openedv/development_board_ATK-DLRK3588B/1_codes/README.md

## Codes

You can find the codes by clicking on [here](https://mega.nz/folder/T1QyjKSI#ysQfY6-w_V1g0kBio79TOQ).
