openedv/development_board_ATK-DLRK3588B/7_hardware/5_Board_mounted_connector_specifications/03_USB-A_connector/Type-A base - copper - side plug.docx

Attribute | Parameter value
Product Catalogue | USB connector
Connector Types | Type-A
Standard | USB 2.0
Male and female | Female
Number of contacts | 4
Number of ports | 1

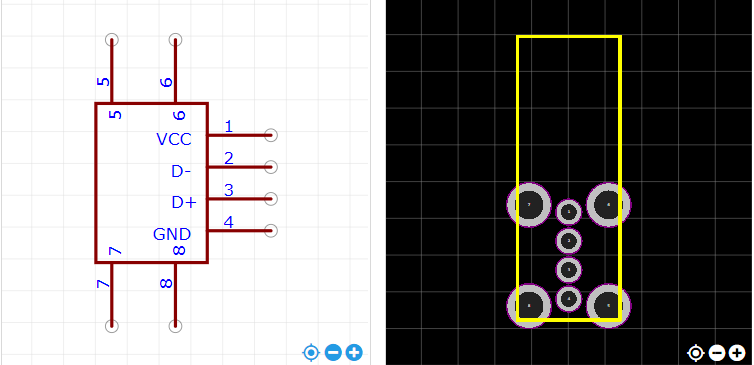
[picture p1: figure]

https://item.szlcsc.com/26978.html
