openedv/development_board_ATK-DLRK3588B/7_hardware/5_Board_mounted_connector_specifications/06_DC_power_socket/DC Port 5.5_2.1.docx

Product Catalogue | AC/DC power connector
Connector Types | DC power socket
Installation method | Curved plug
Contact inner diameter | -
Contact outer diameter | -
Rated current | 5A
Rated voltage | 20V
Operating temperature range | -25℃~+70℃

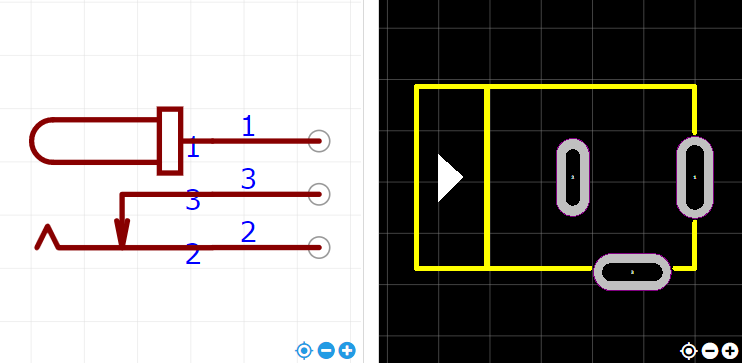
[picture p2: figure]

https://item.szlcsc.com/419795.html
