openedv/development_board_ATK-DLRK3588B/7_hardware/5_Board_mounted_connector_specifications/07_TF_card_slot/Self-playing MicroSD card (TF card) slot.docx

Product Catalogue | SD card connector
Card connection method | Self-folding type
Card type | MicroSD card (TF card)
Connector type | Card slot
Maximum height of the body | -
Contact material | -
Contact coating | -
Operating temperature range | -
Welding temperature (maximum value) | -

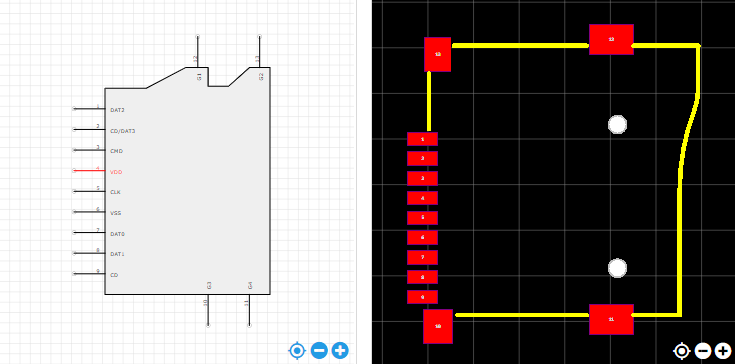
[picture p3: figure]

https://item.szlcsc.com/112422.html
