openedv/development_board_ATK-DLRK3588B/7_hardware/5_Board_mounted_connector_specifications/08_NANO_SIM_card_slot/Self-playing NanoSIM card slot 7P without pillars.docx

Product Catalogue | SIM card connector
Card connection method | Self-retracting type
Card type | NanoSIM card
Connector type | Card slot
Maximum height of the body | 1.25mm
Contact material | Copper alloy
Contact coating | Gold plating
Operating temperature range | -40℃~+85℃
Welding temperature (maximum value) | 260℃

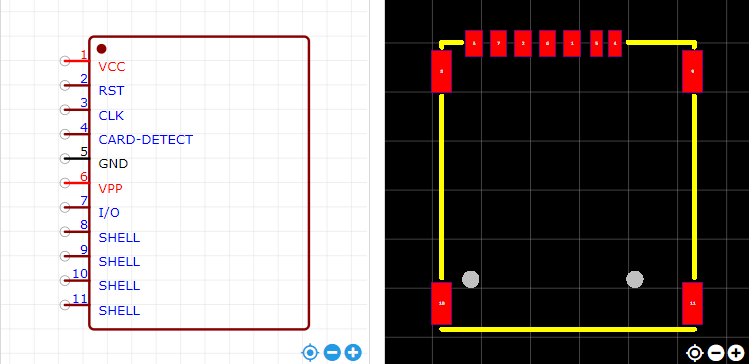
[picture p4: figure]

https://item.szlcsc.com/353303.html
