openedv/development_board_ATK-DLRK3588B/7_hardware/5_Board_mounted_connector_specifications/10_2mm_pitch_mounting_socket_22P(ALIENTEK_MIPI_Camera_Interface)/C2925567_2MM2X11P.docx

属性 | 参数值
商品目录 | 排母
间距 | 2mm
总孔位数 | 22
排数 | 2
插孔结构 | 2x11P
行距 | 2mm
安装类型 | 直插
圆孔/方孔 | 方孔
额定电流 | 2A
额定电压 | -
插孔方向 | 顶部
塑高 | 4.3mm
工作温度范围 | -40℃~+105℃

https://item.szlcsc.com/3245400.html
