openedv/development_board_ATK-DLRK3588B/7_hardware/5_Board_mounted_connector_specifications/11_FPC_Connector_26P (ALIENTEK_MIPI_Screen_Interface)/C2911851_0.5MMP quantity_26 flip-down connection.docx

Product Catalogue | FFC/FPC connector
Spacing | 0.5mm
Number of contacts | 26
Locking feature | Flip cover style
Installation type | Supporting pad for bed
Contact type | Continued below
Board height | 2mm
Thickness of the flexible cable connected | 0.3mm
Operating temperature range | -20℃~+85℃

https://item.szlcsc.com/3194107.html
