openedv/development_board_ATK-DLRK3588B/7_hardware/5_Board_mounted_connector_specifications/14_Antenna_base/RF radio frequency coaxial connector SMA inner hole elbow connector.docx

Product Catalogue | RF radio frequency coaxial connector
Connector type | Board end
Radio frequency series | SMA
Interface type | Inner bore
Number of ports | 1
Impedance | 50Ω
Frequency - Maximum value | 3GHz
Style | Bend
Interface diameter | 5.35mm
Interface length/height | -
Operating temperature range | -55℃~+125℃

External thread nut half-thread SMA - KWE bend angle (90 degrees), fully copper plated with gold

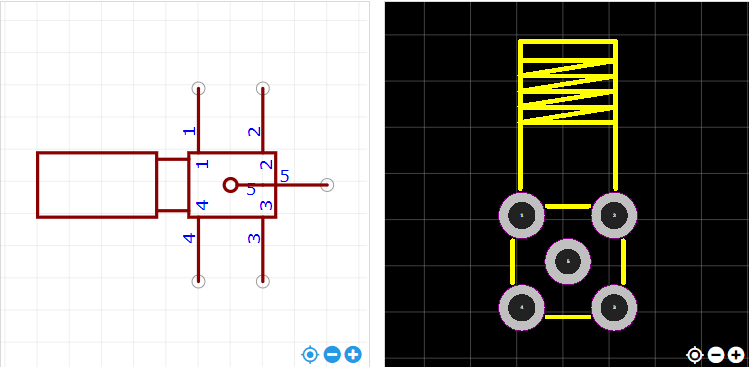
[picture p5: figure]

https://item.szlcsc.com/985455.html
