openedv/development_board_ATK-DLRK3588B/7_hardware/5_Board_mounted_connector_specifications/01_Core_board-to-board_connector/Copper column specifications M2x4x1.5 + 2.9x1.0mm.txt

购买链接参考：https://item.taobao.com/item.htm?spm=a1z09.2.0.0.31962e8d5RZ1vR&id=621670841713&_u=vjqt9po3ed8
