openedv/development_board_ATK-DLRK3588B/2_sch/02_Other_Modules_Schematic_Diagram/ATK-MCIMX415 V1.4 schematic diagram.pdf

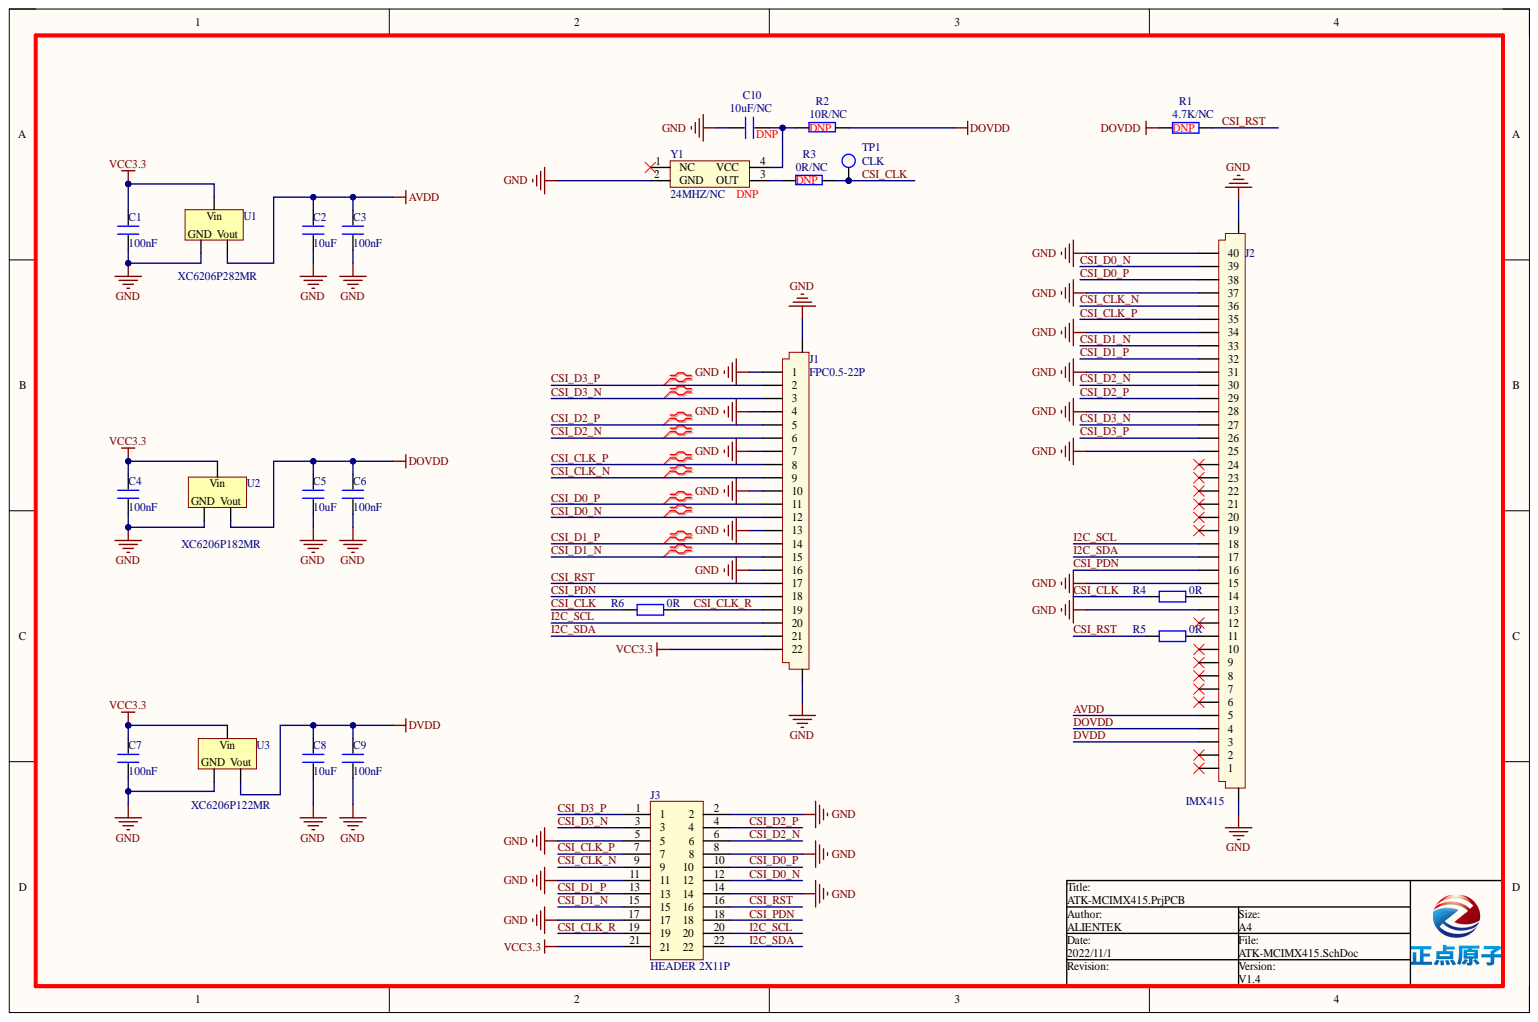
[picture p61: page 2]
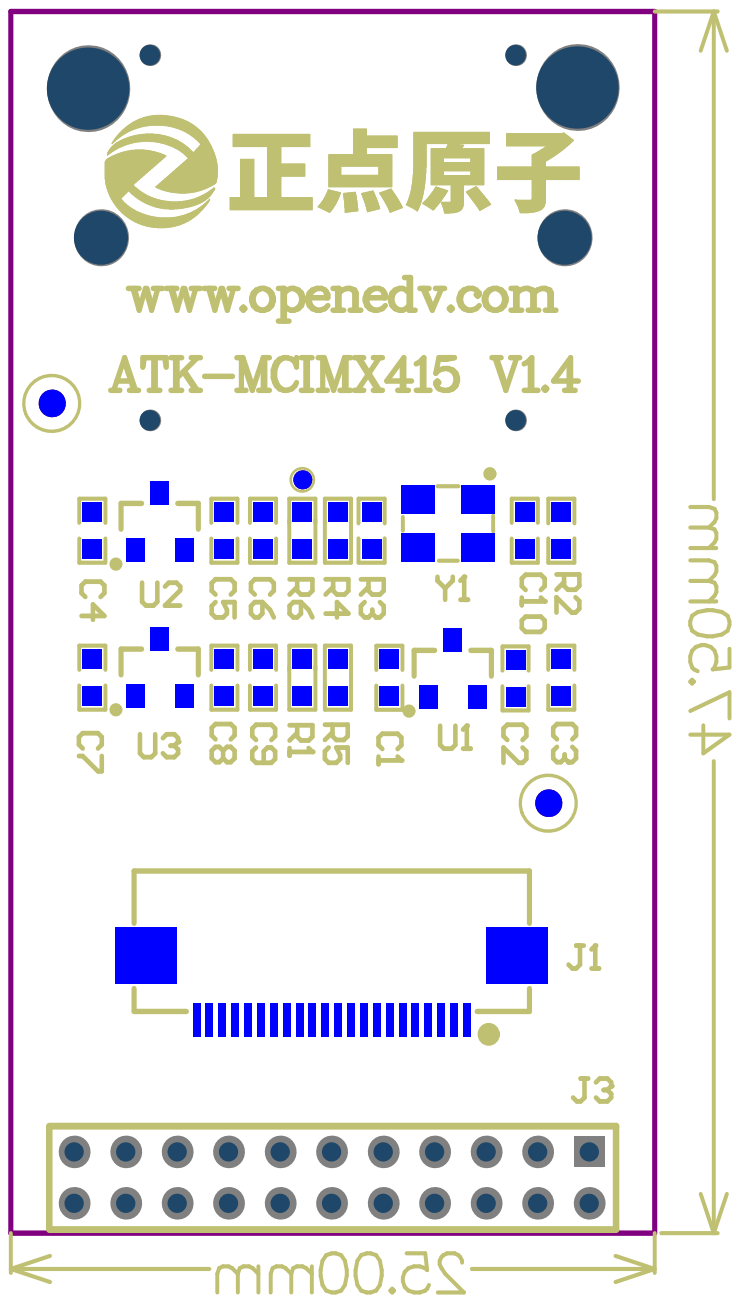
[picture p62: page 3]
