openedv/development_board_ATK-DLRK3588B/3_core_board_data/3_core_board_mechanical_structure/ATK-CLRK3588B V1.0(Core board structure size diagram).pdf

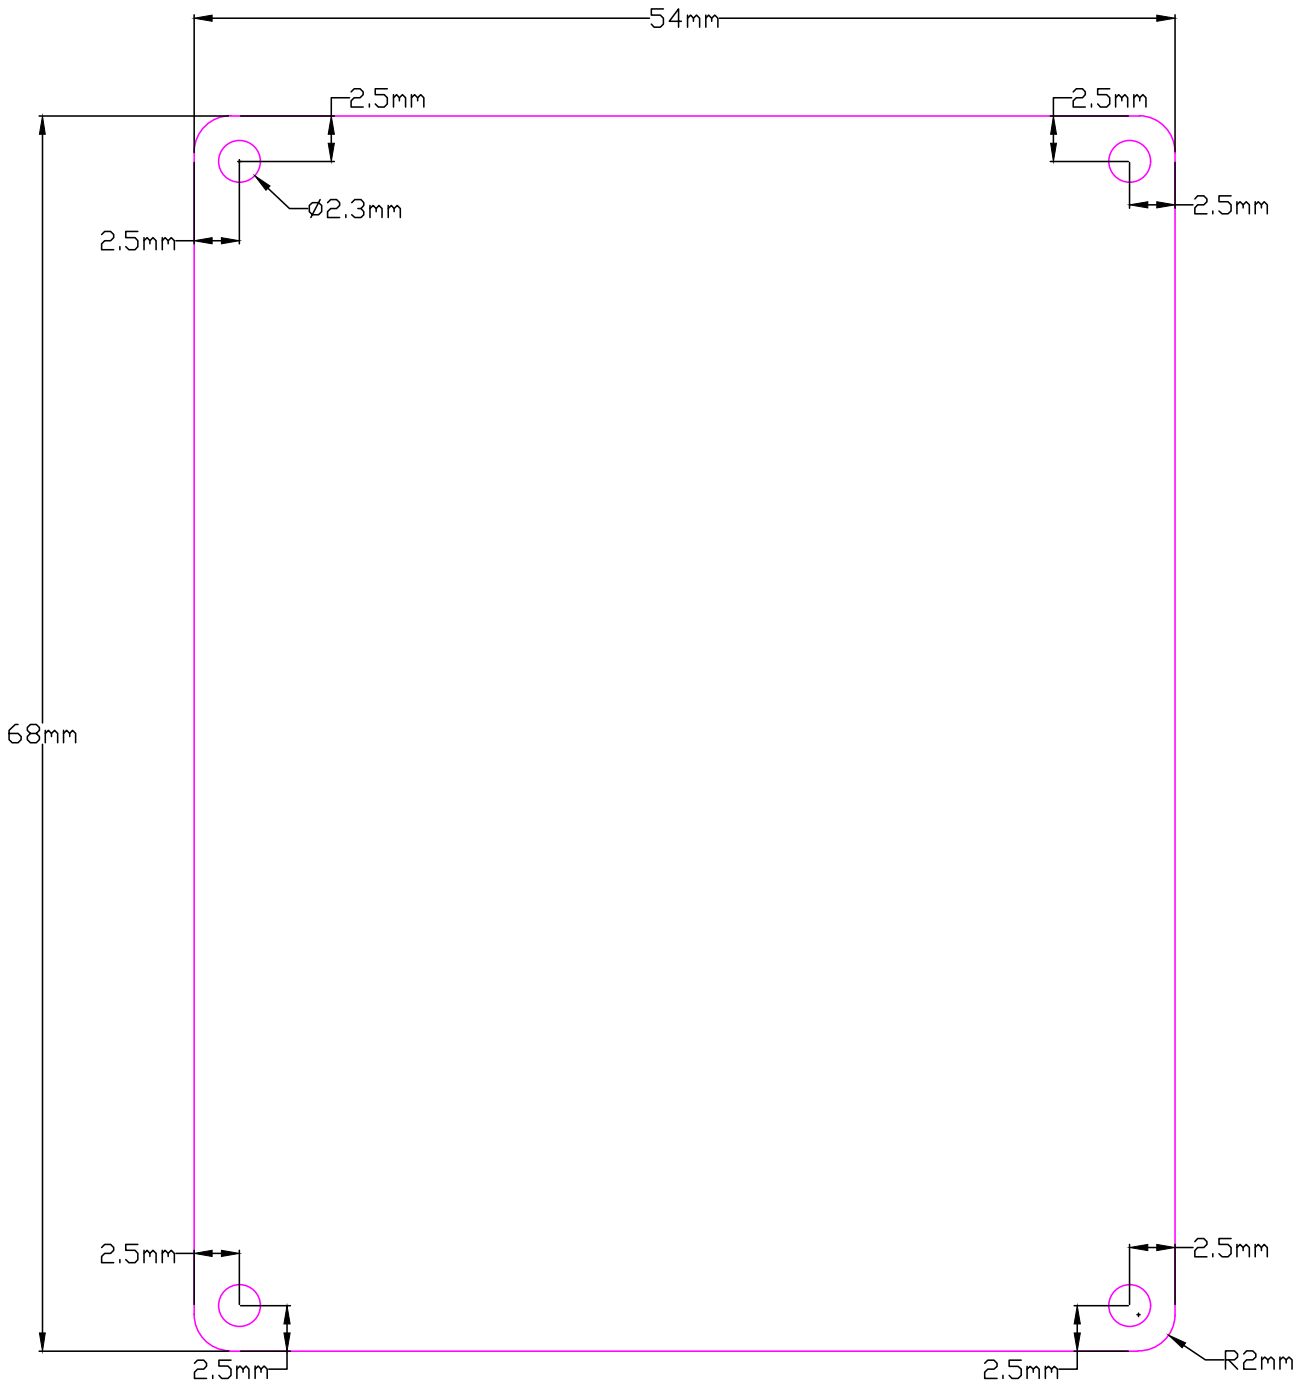
[picture p63: page 1]
