openedv/development_board_ATK-DLRK3588B/7_hardware/5_Board_mounted_connector_specifications/04_Type-C_Connector/USB 12P,Type C.pdf

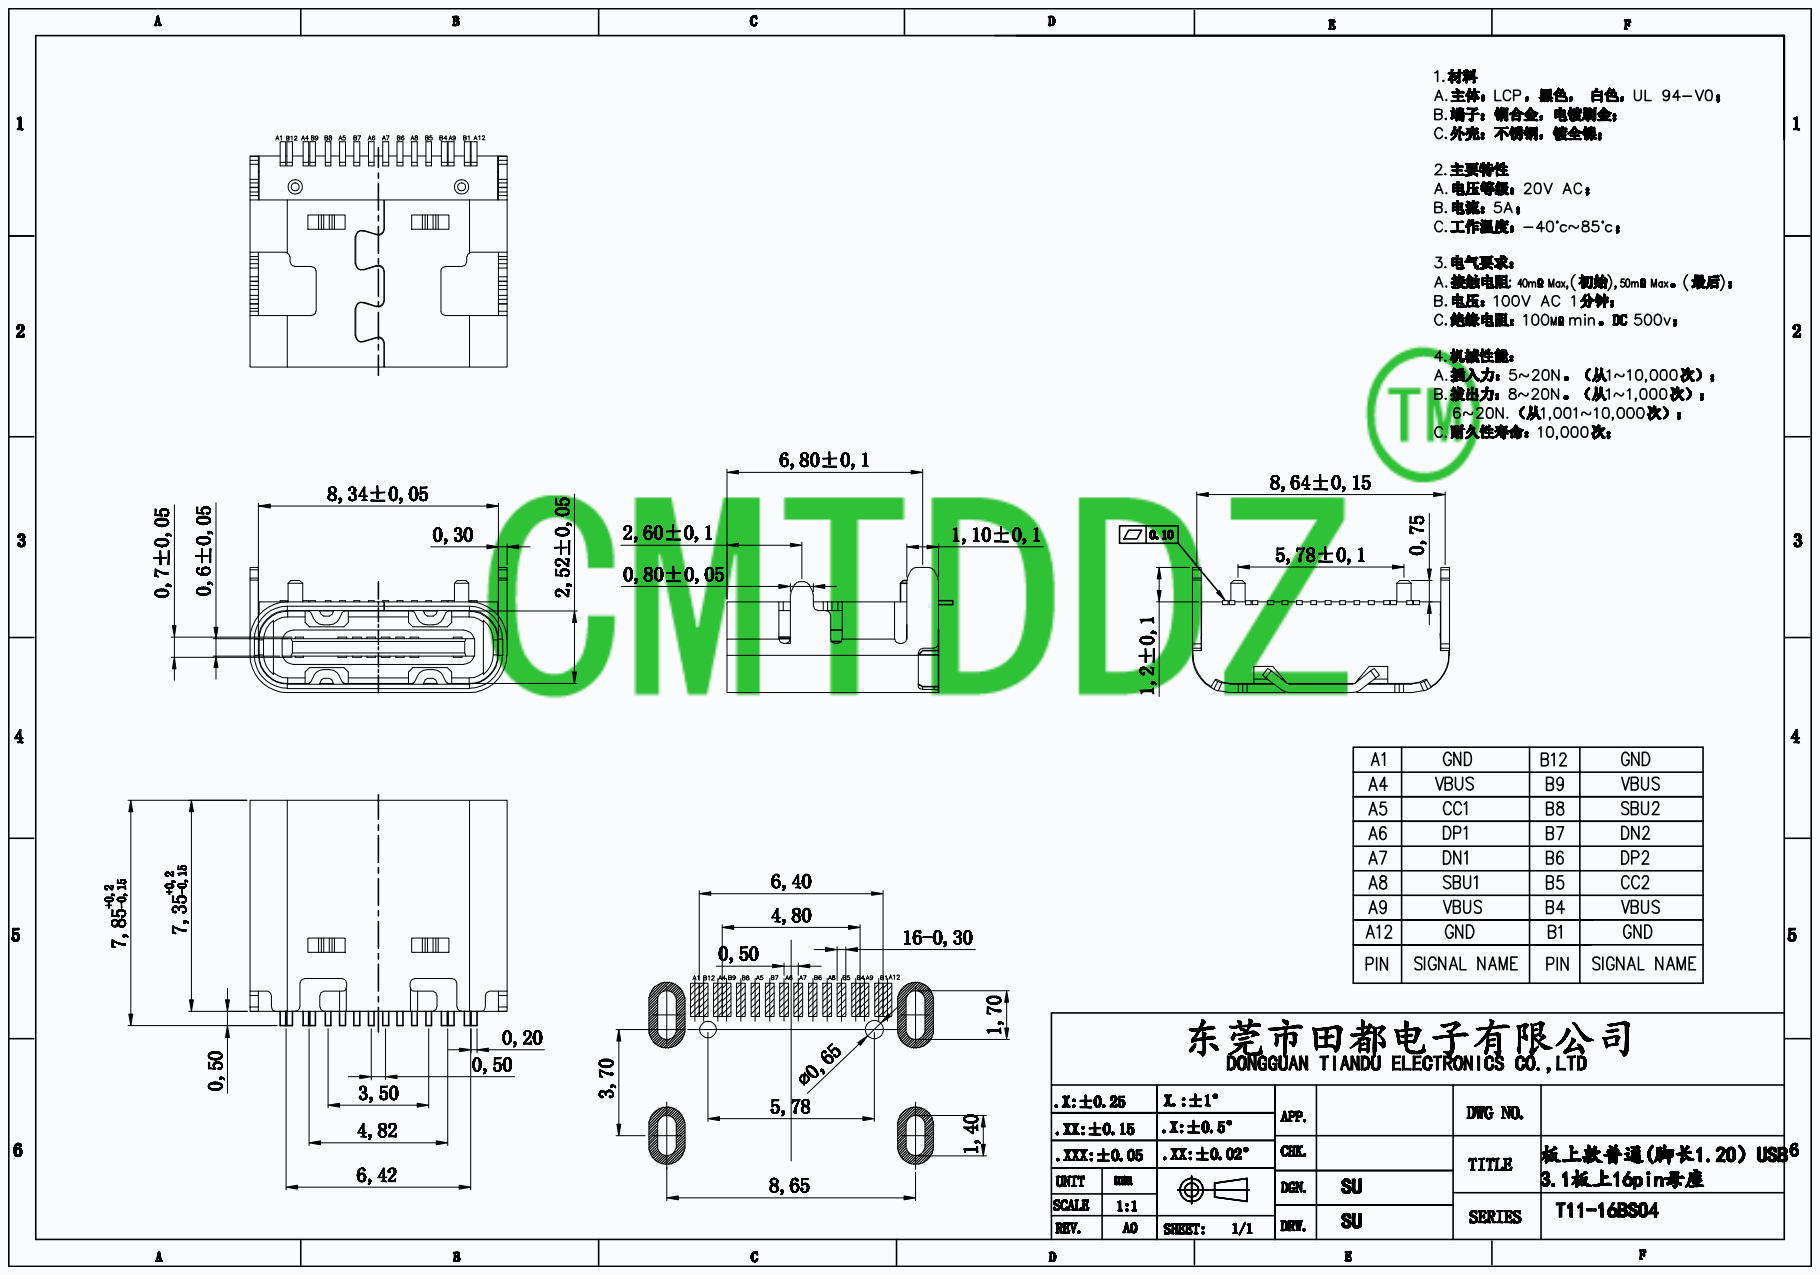
[picture p64: page 1]
