openedv/development_board_ATK-DLRK3588B/7_hardware/5_Board_mounted_connector_specifications/15_M.2_Socket/M.2 M_KEY Gold Finger Connector - LOTES (Jiaze Terminal) Gold Finger Connector Specification Book.PDF

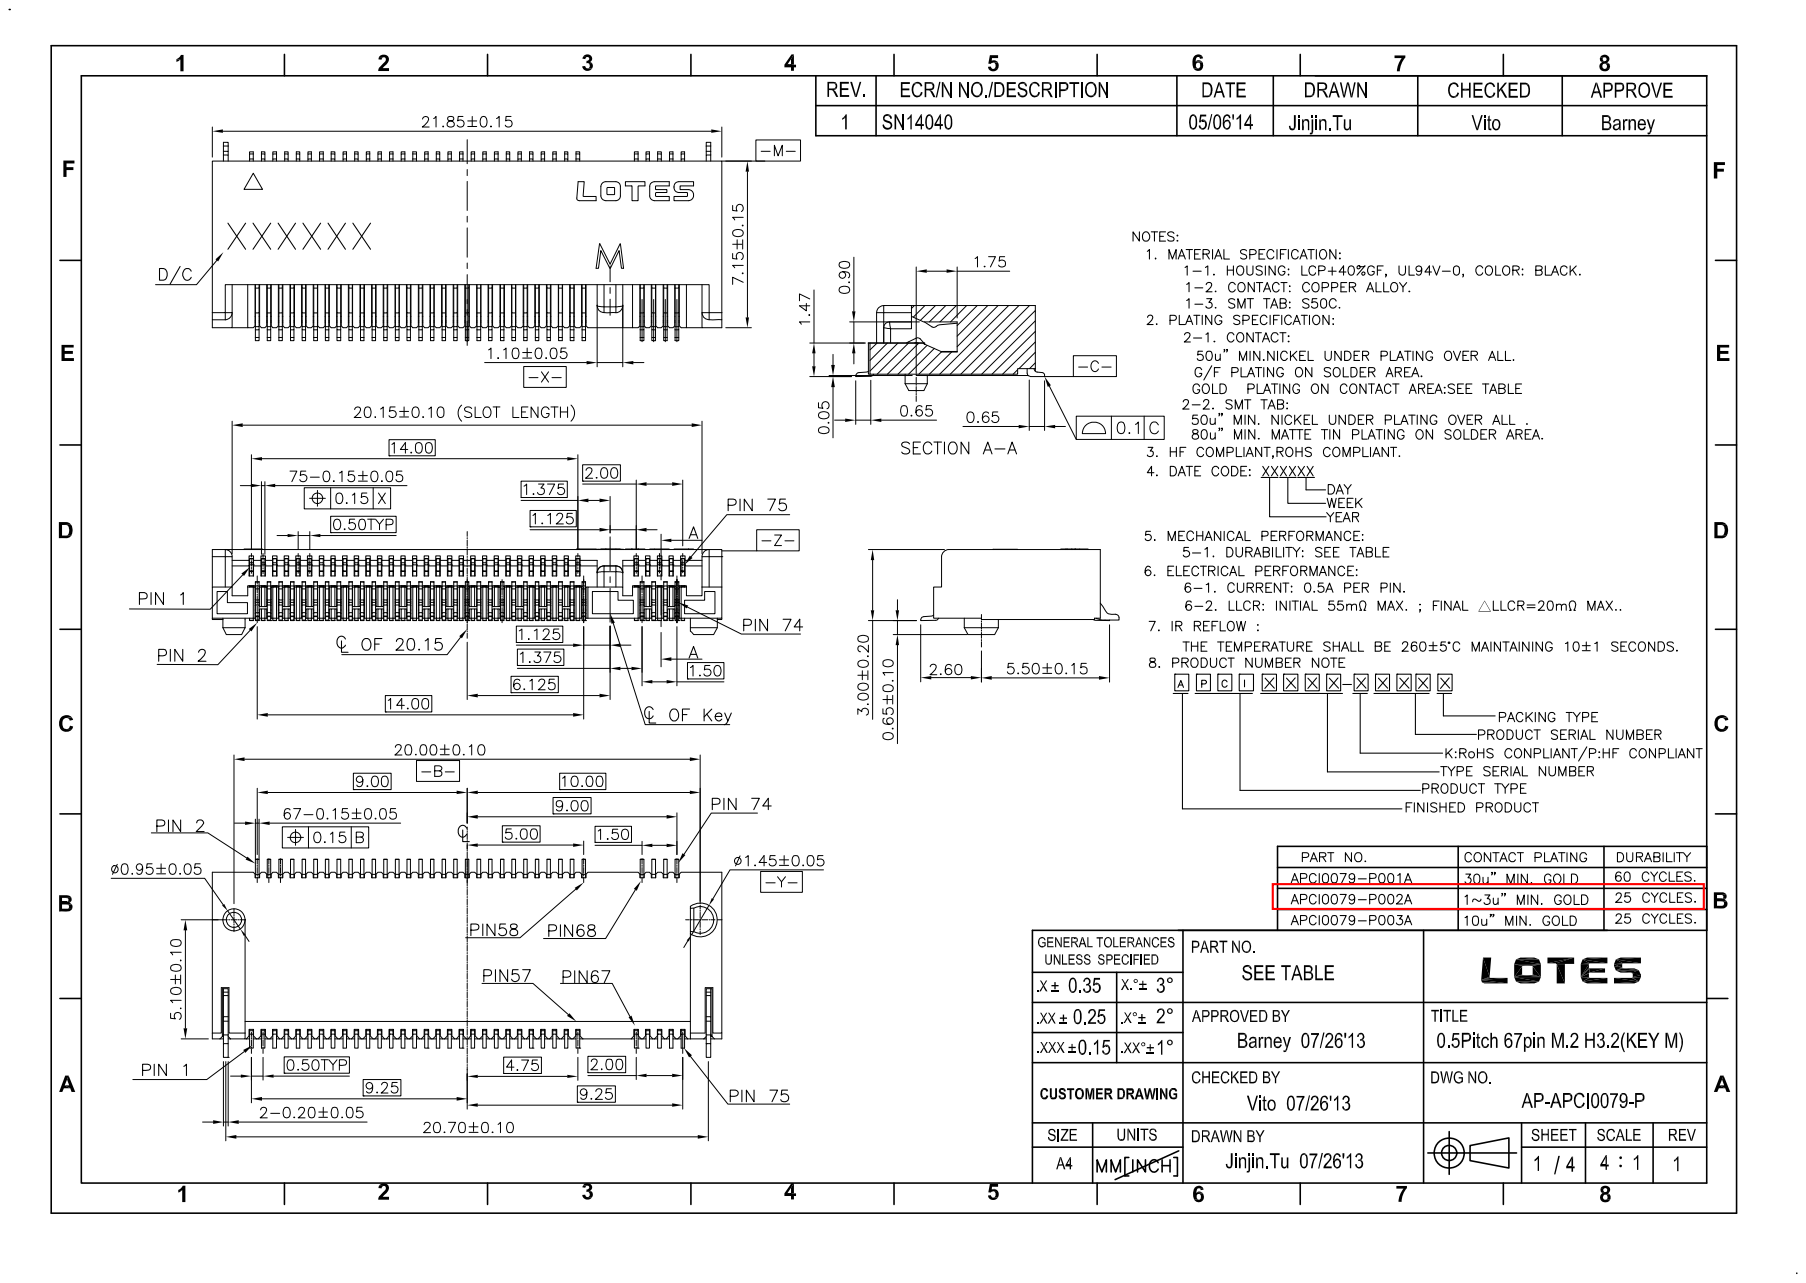
[picture p65: page 1]
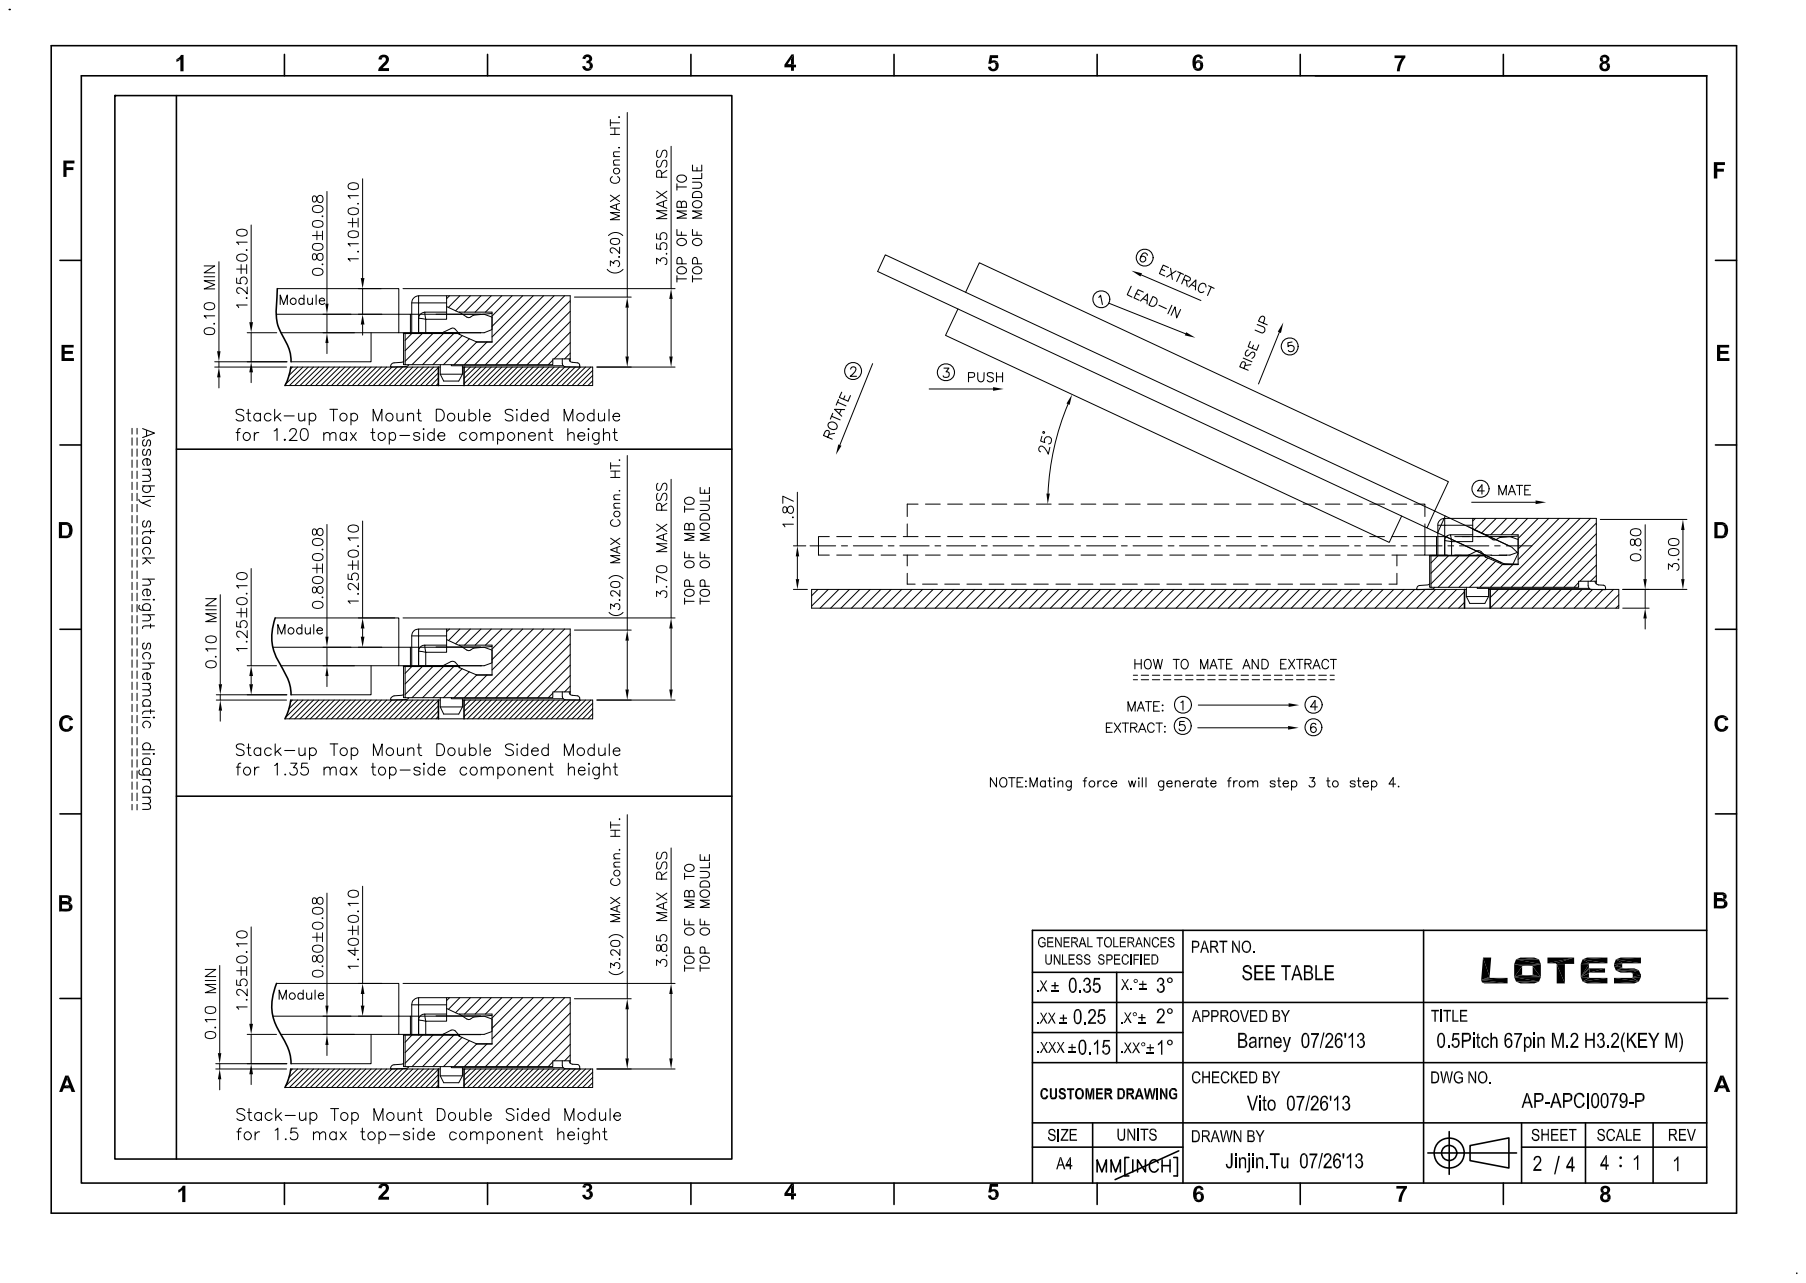
[picture p66: page 2]
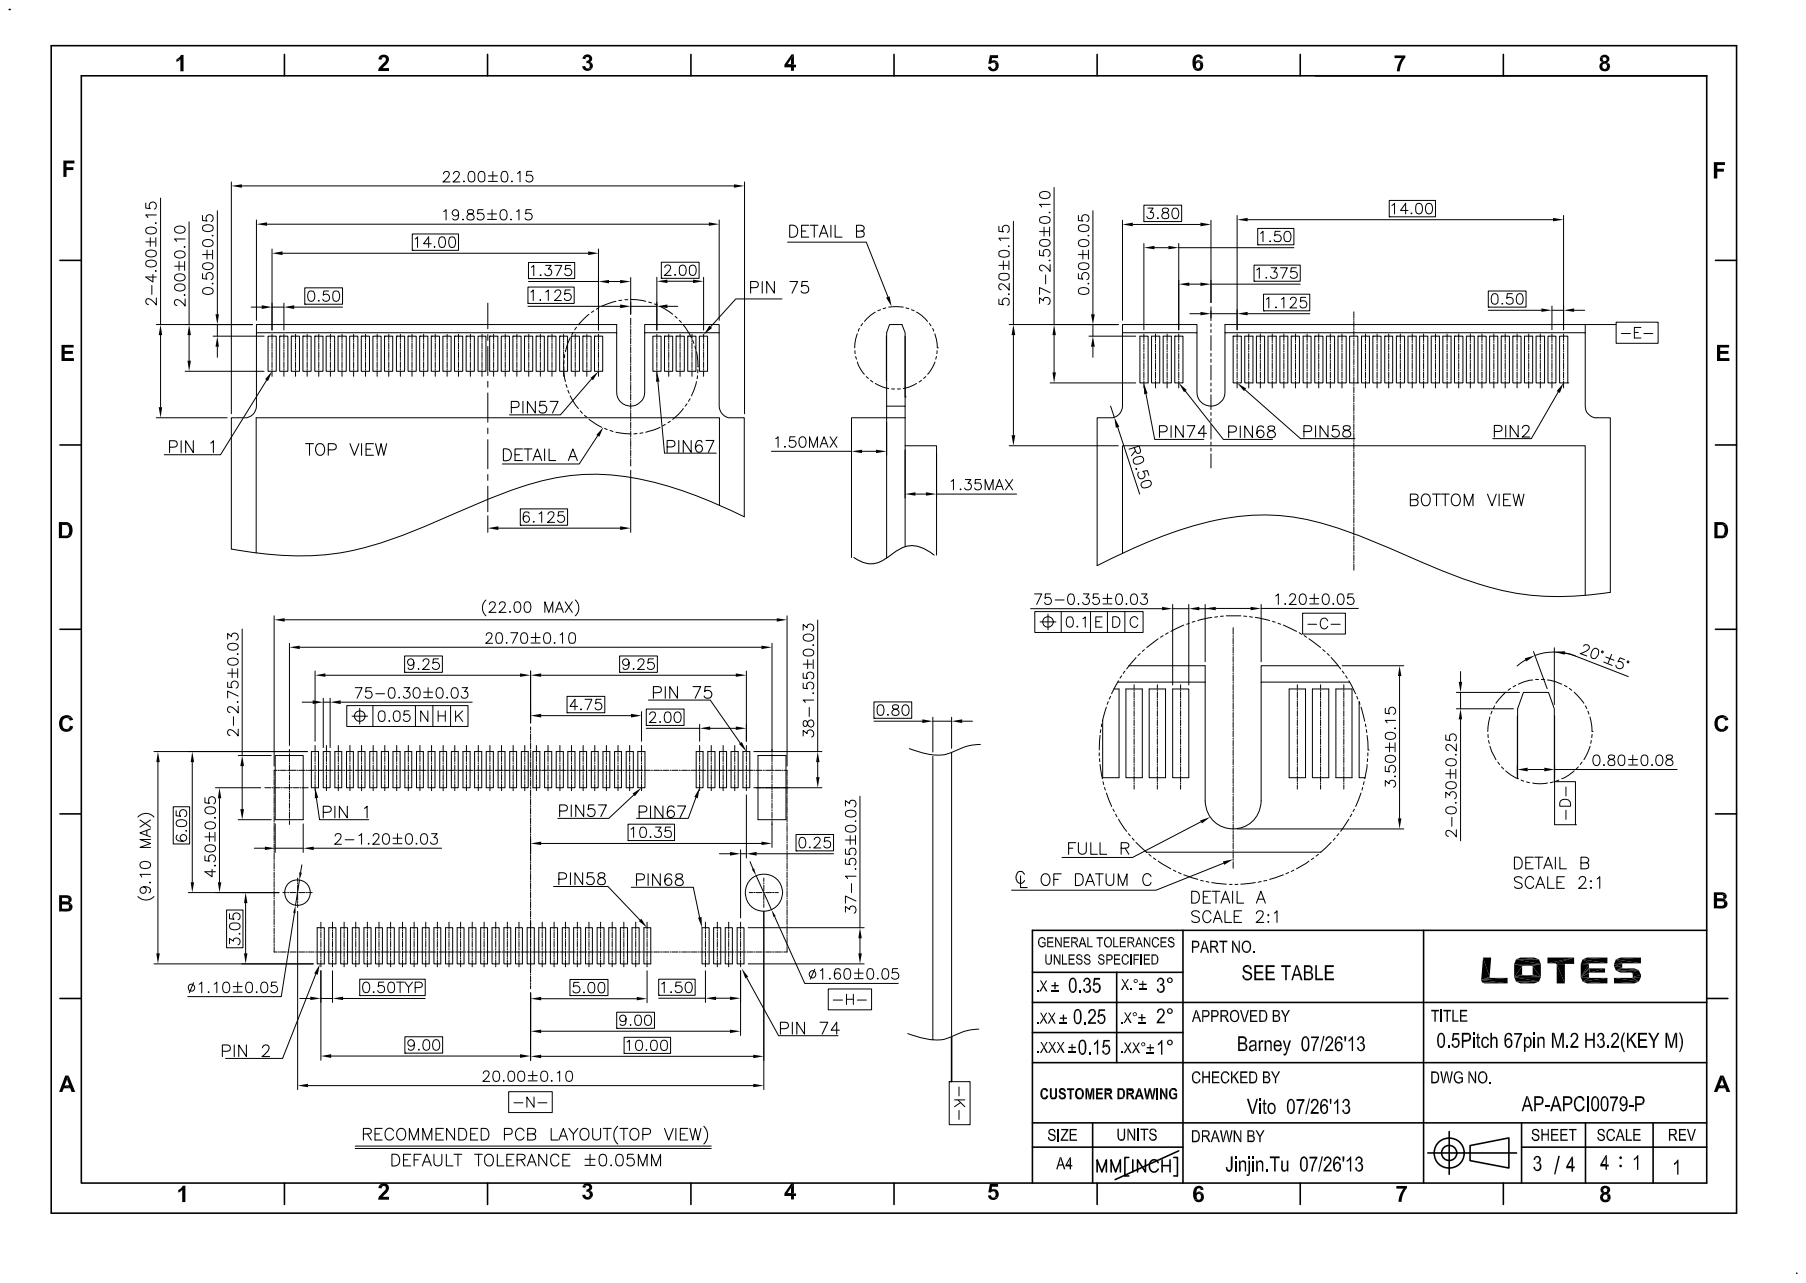
[picture p67: page 3]
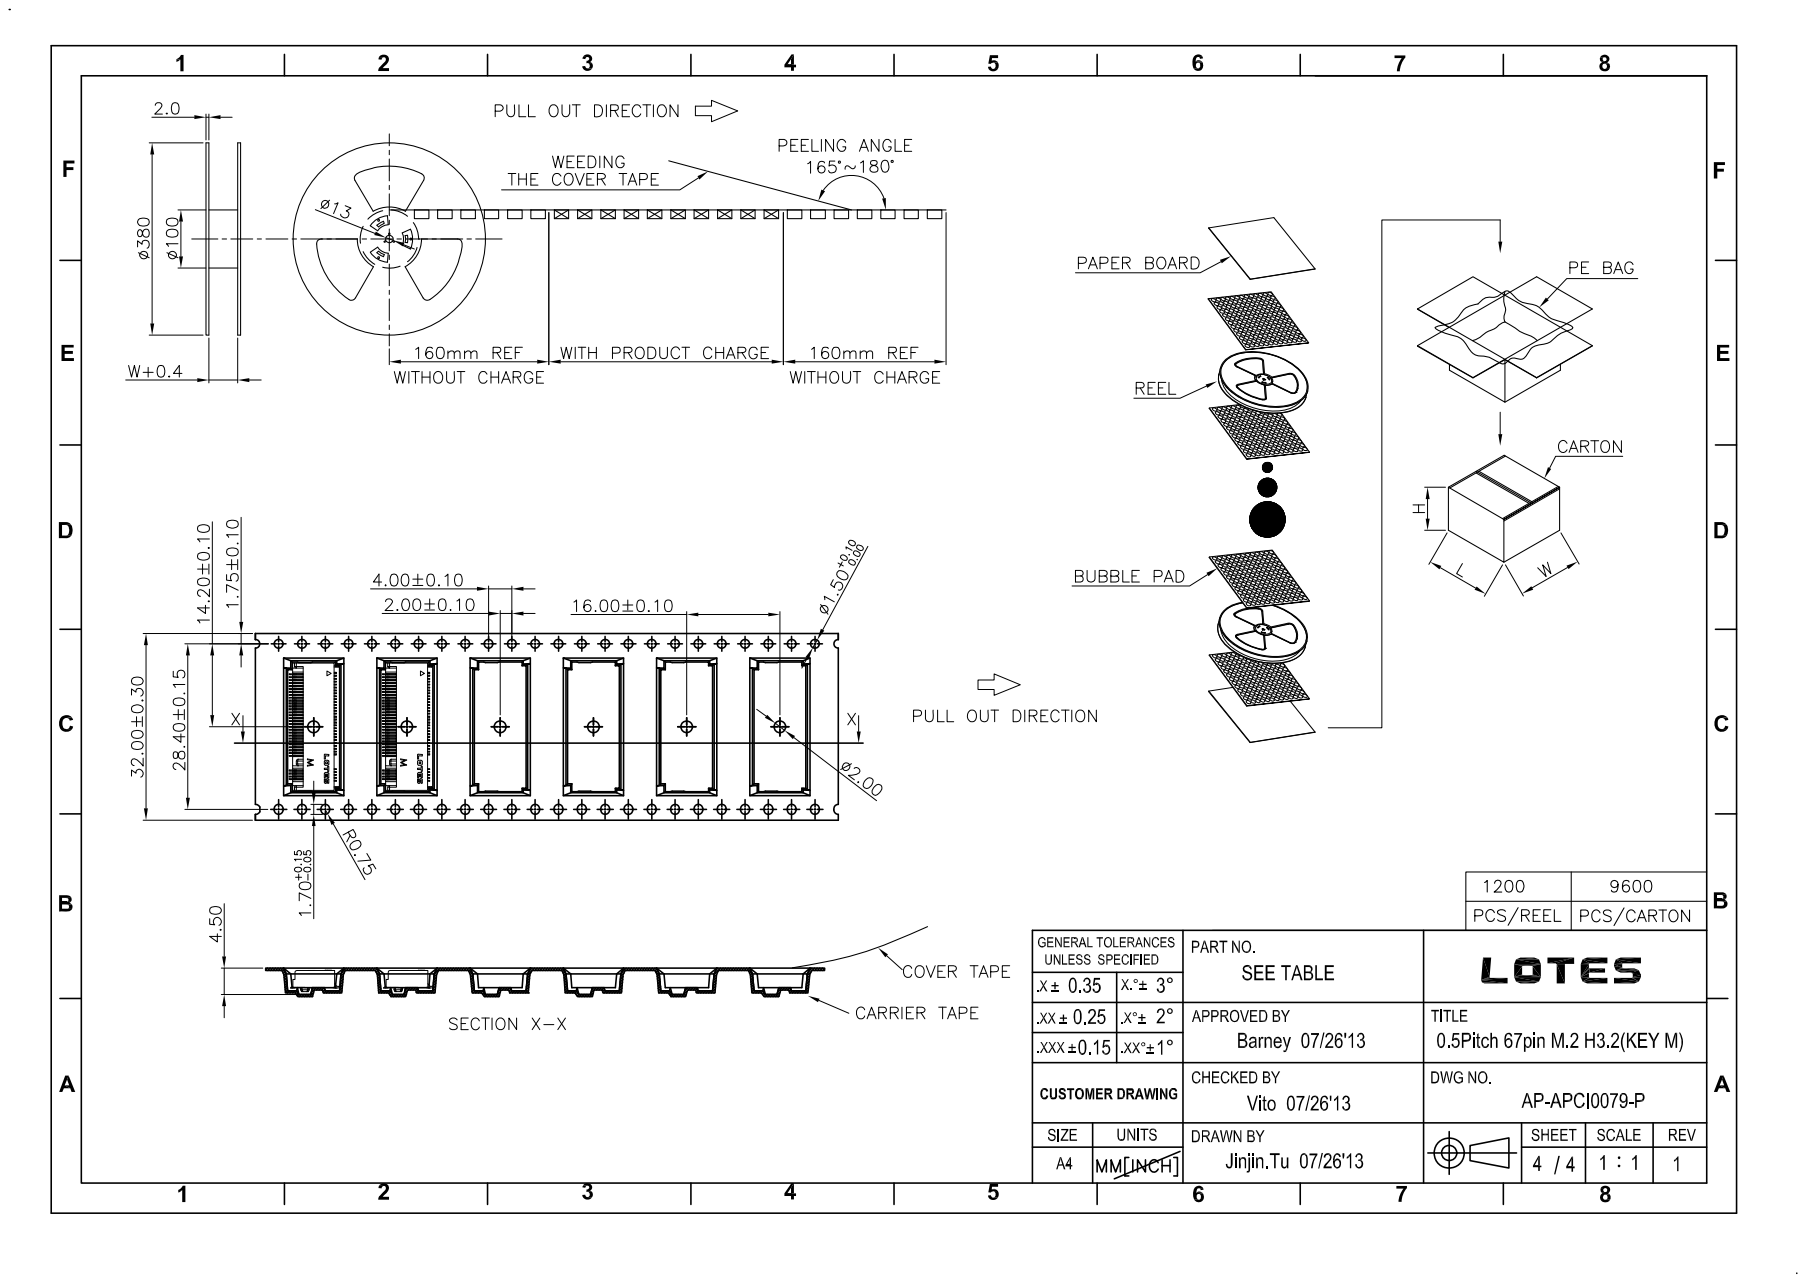
[picture p68: page 4]
