openedv/development_board_ATK-DLRK3588B/7_hardware/5_Board_mounted_connector_specifications/16_HDMI_socket/XUNPU D-SUB_DVI_HDMI Connector Specification Document.PDF

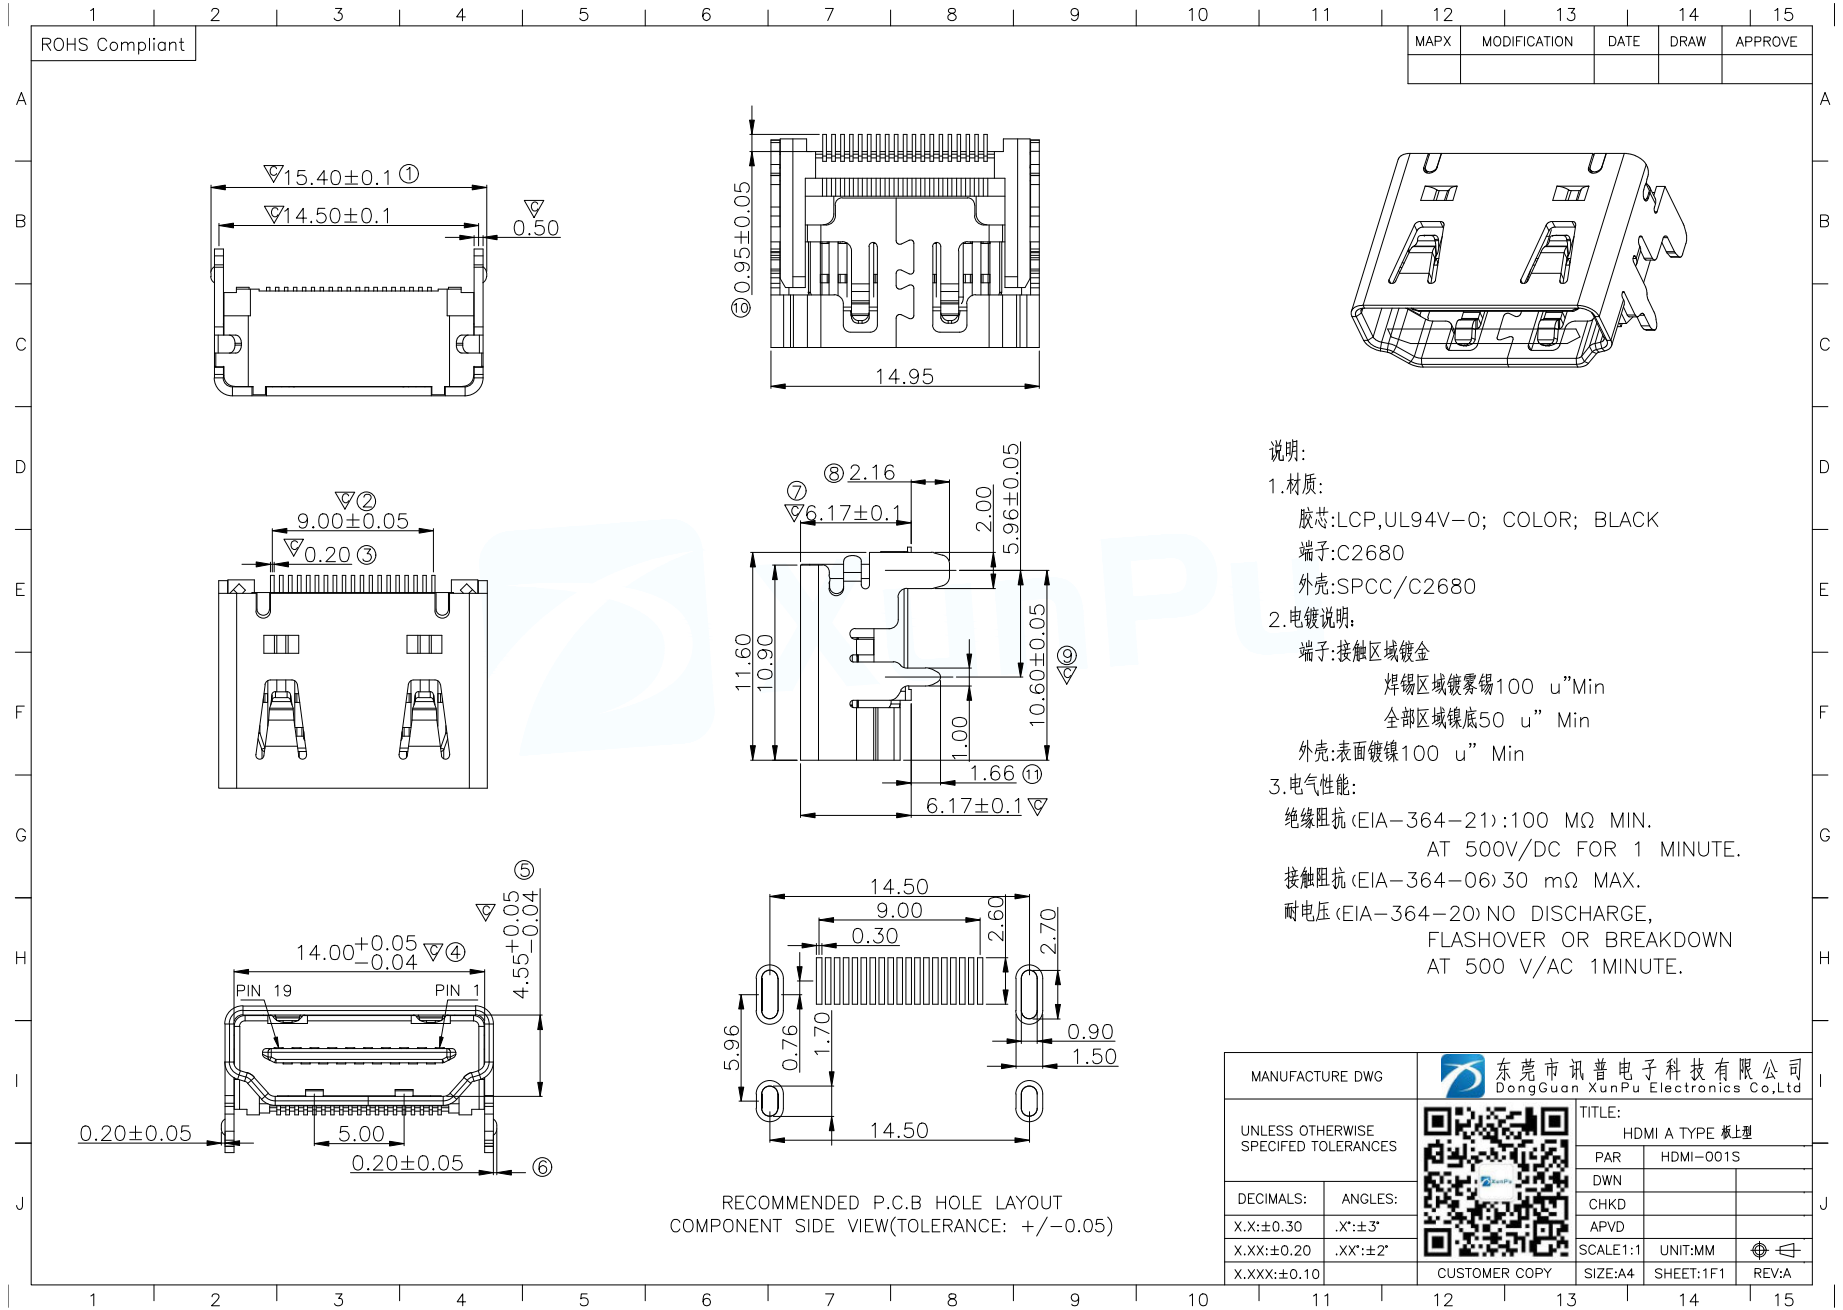
[picture p69: page 1]
