openedv/development_board_ATK-DLRK3588B/7_hardware/5_Board_mounted_connector_specifications/17_SATA_connector/SATA 7P Specification Document - FOXCONN Gold Finger Connector Specification Document.PDF

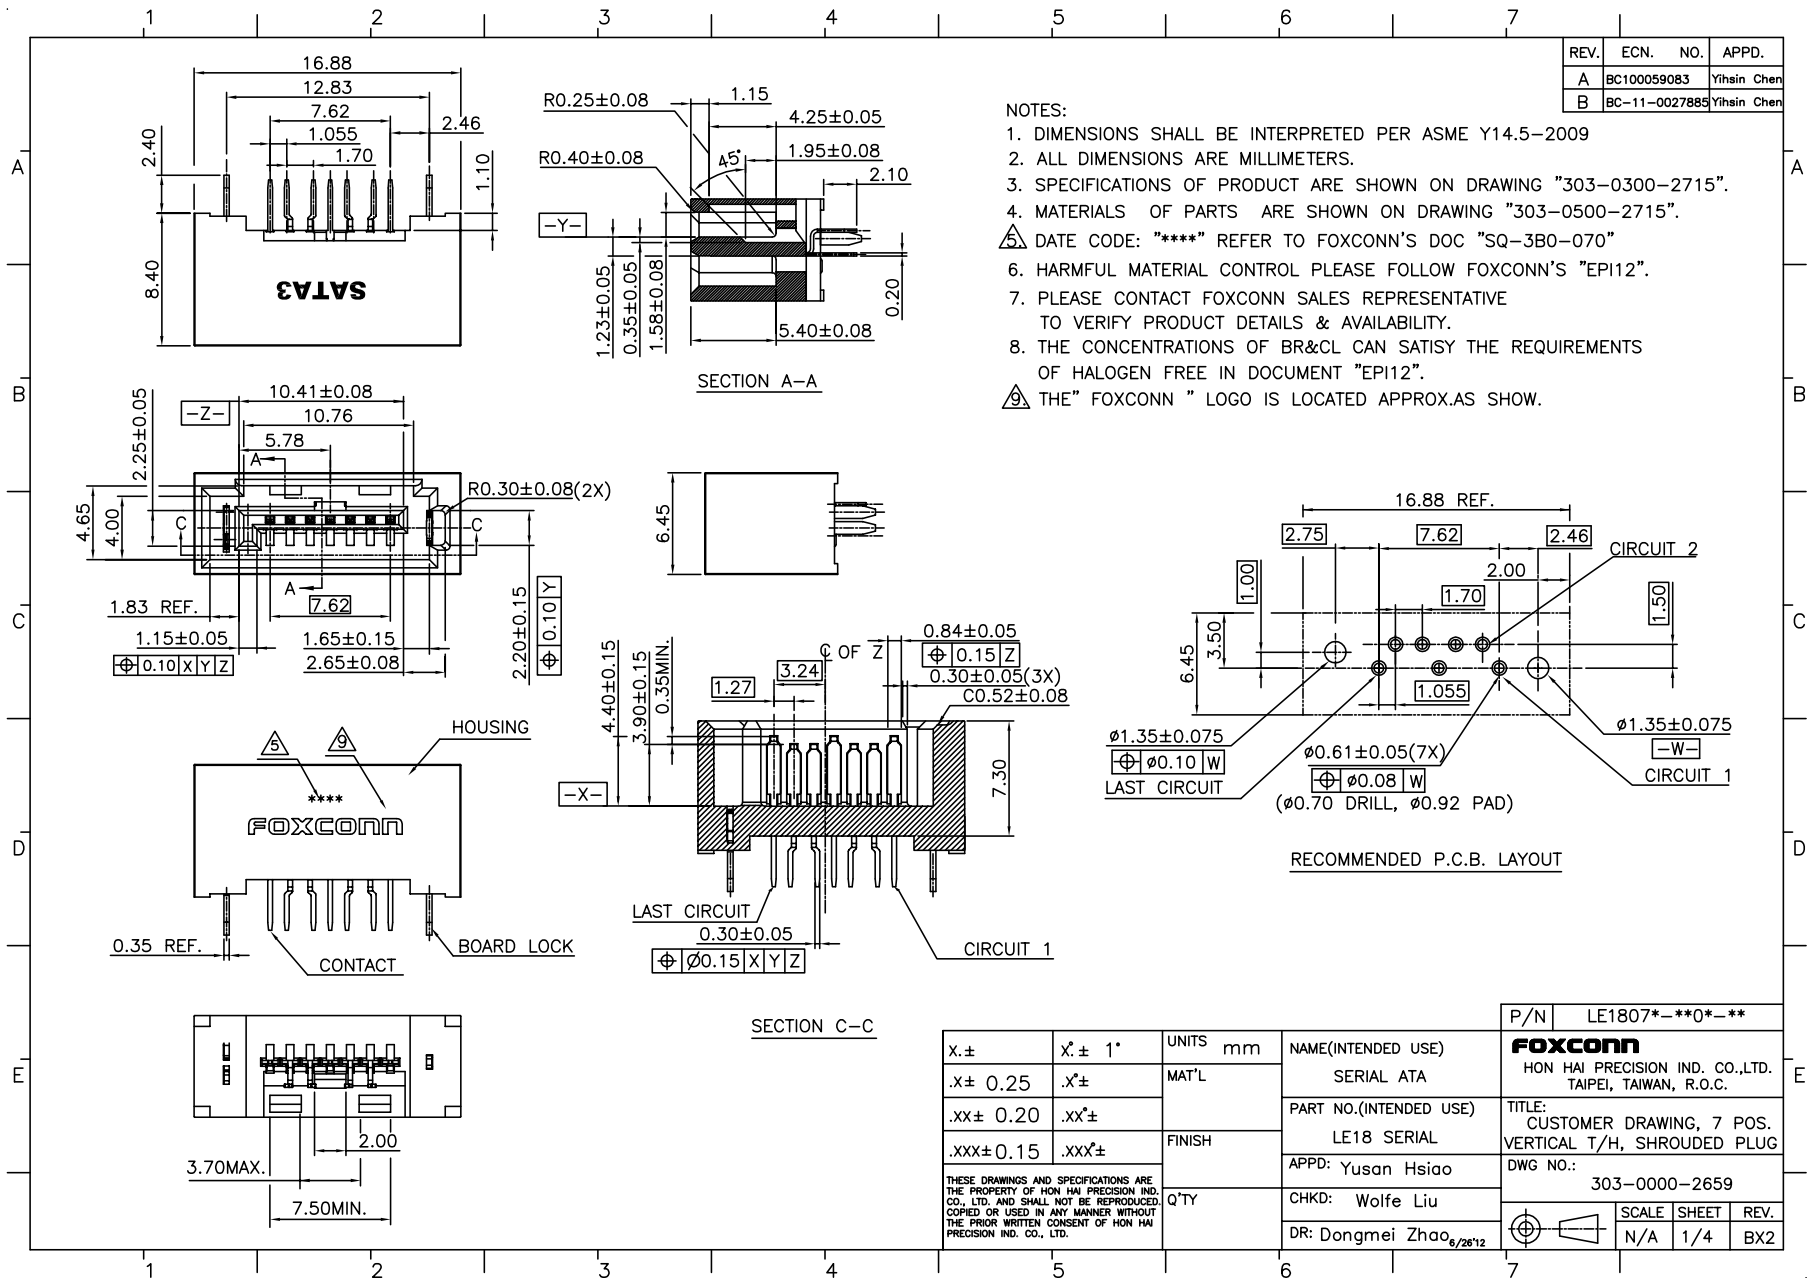
[picture p70: page 1]
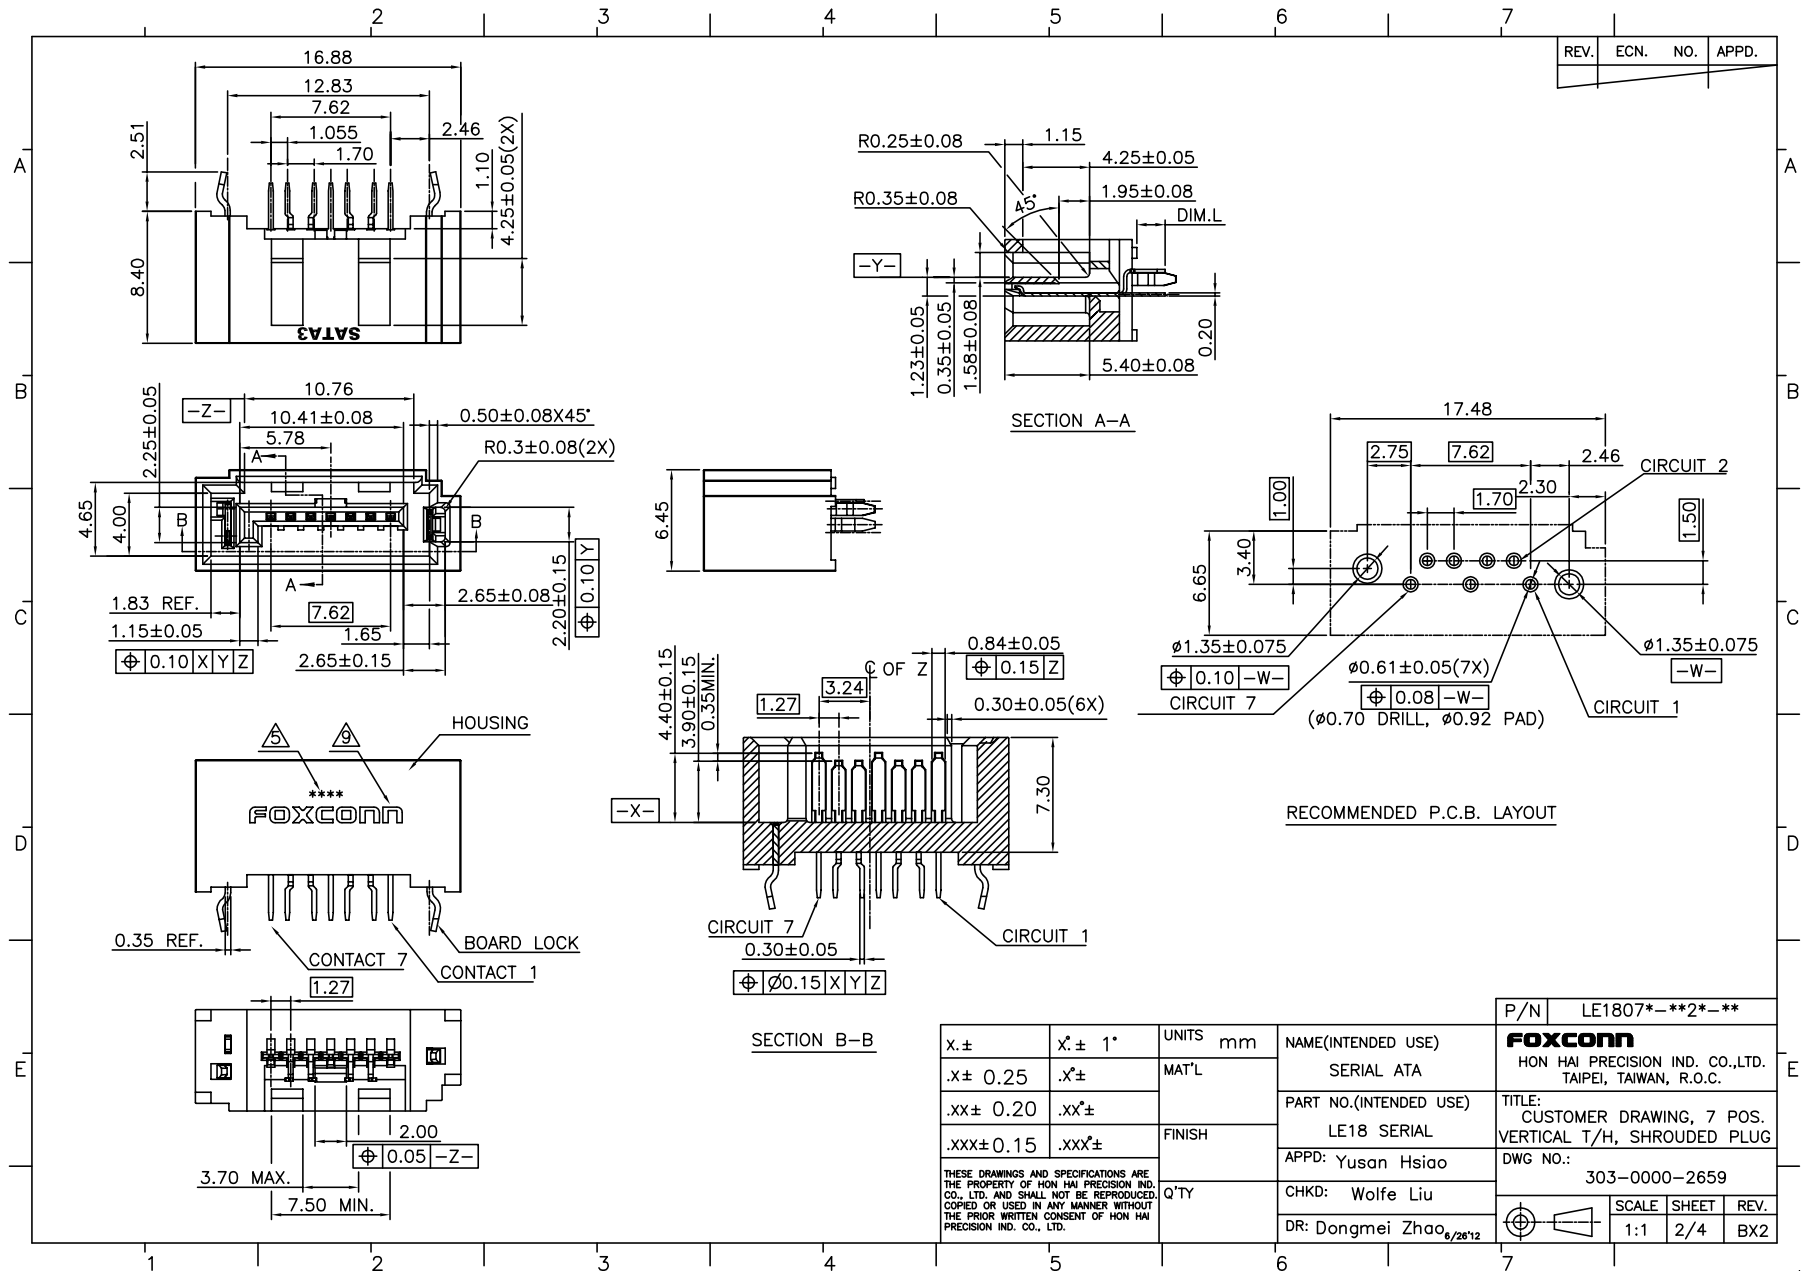
[picture p71: page 2]
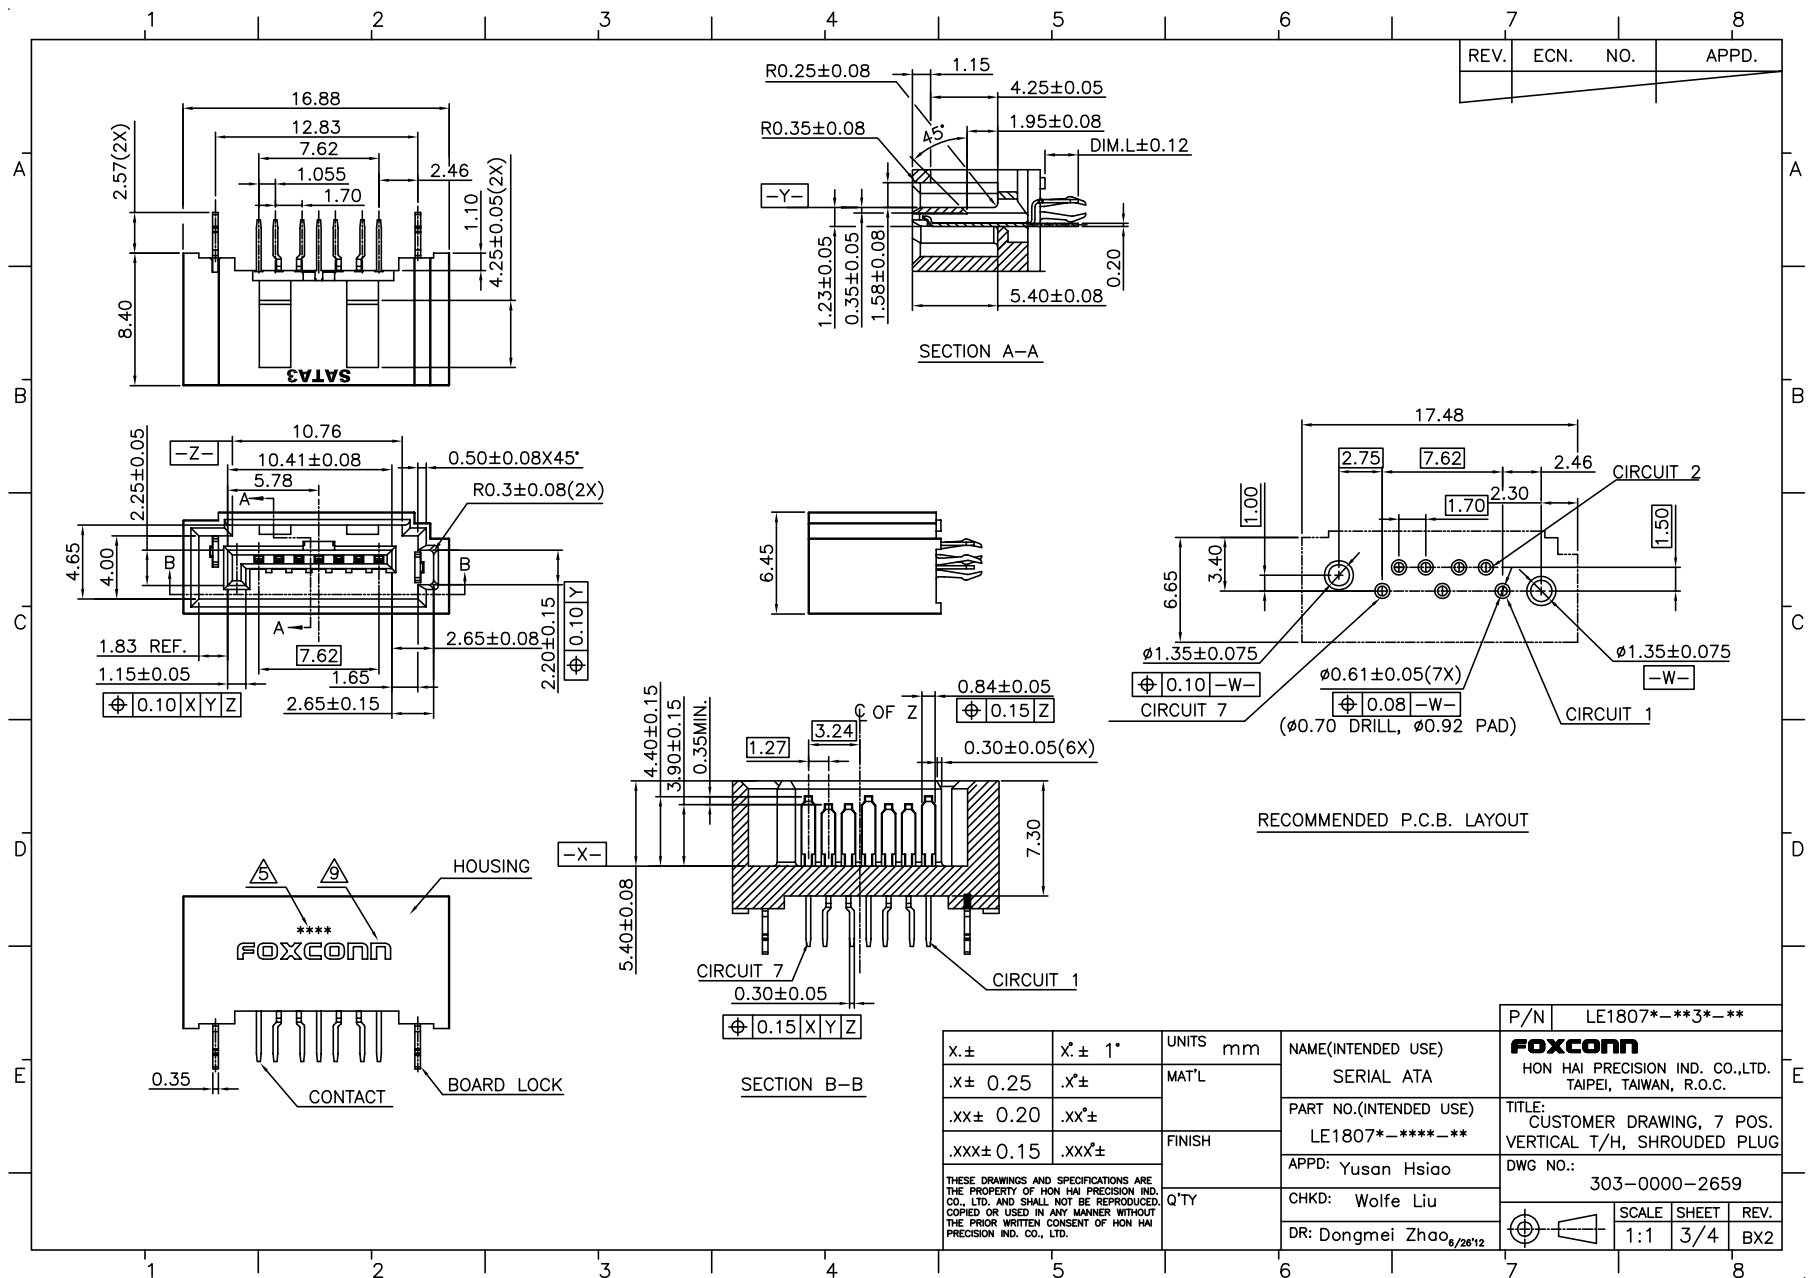
[picture p72: page 3]
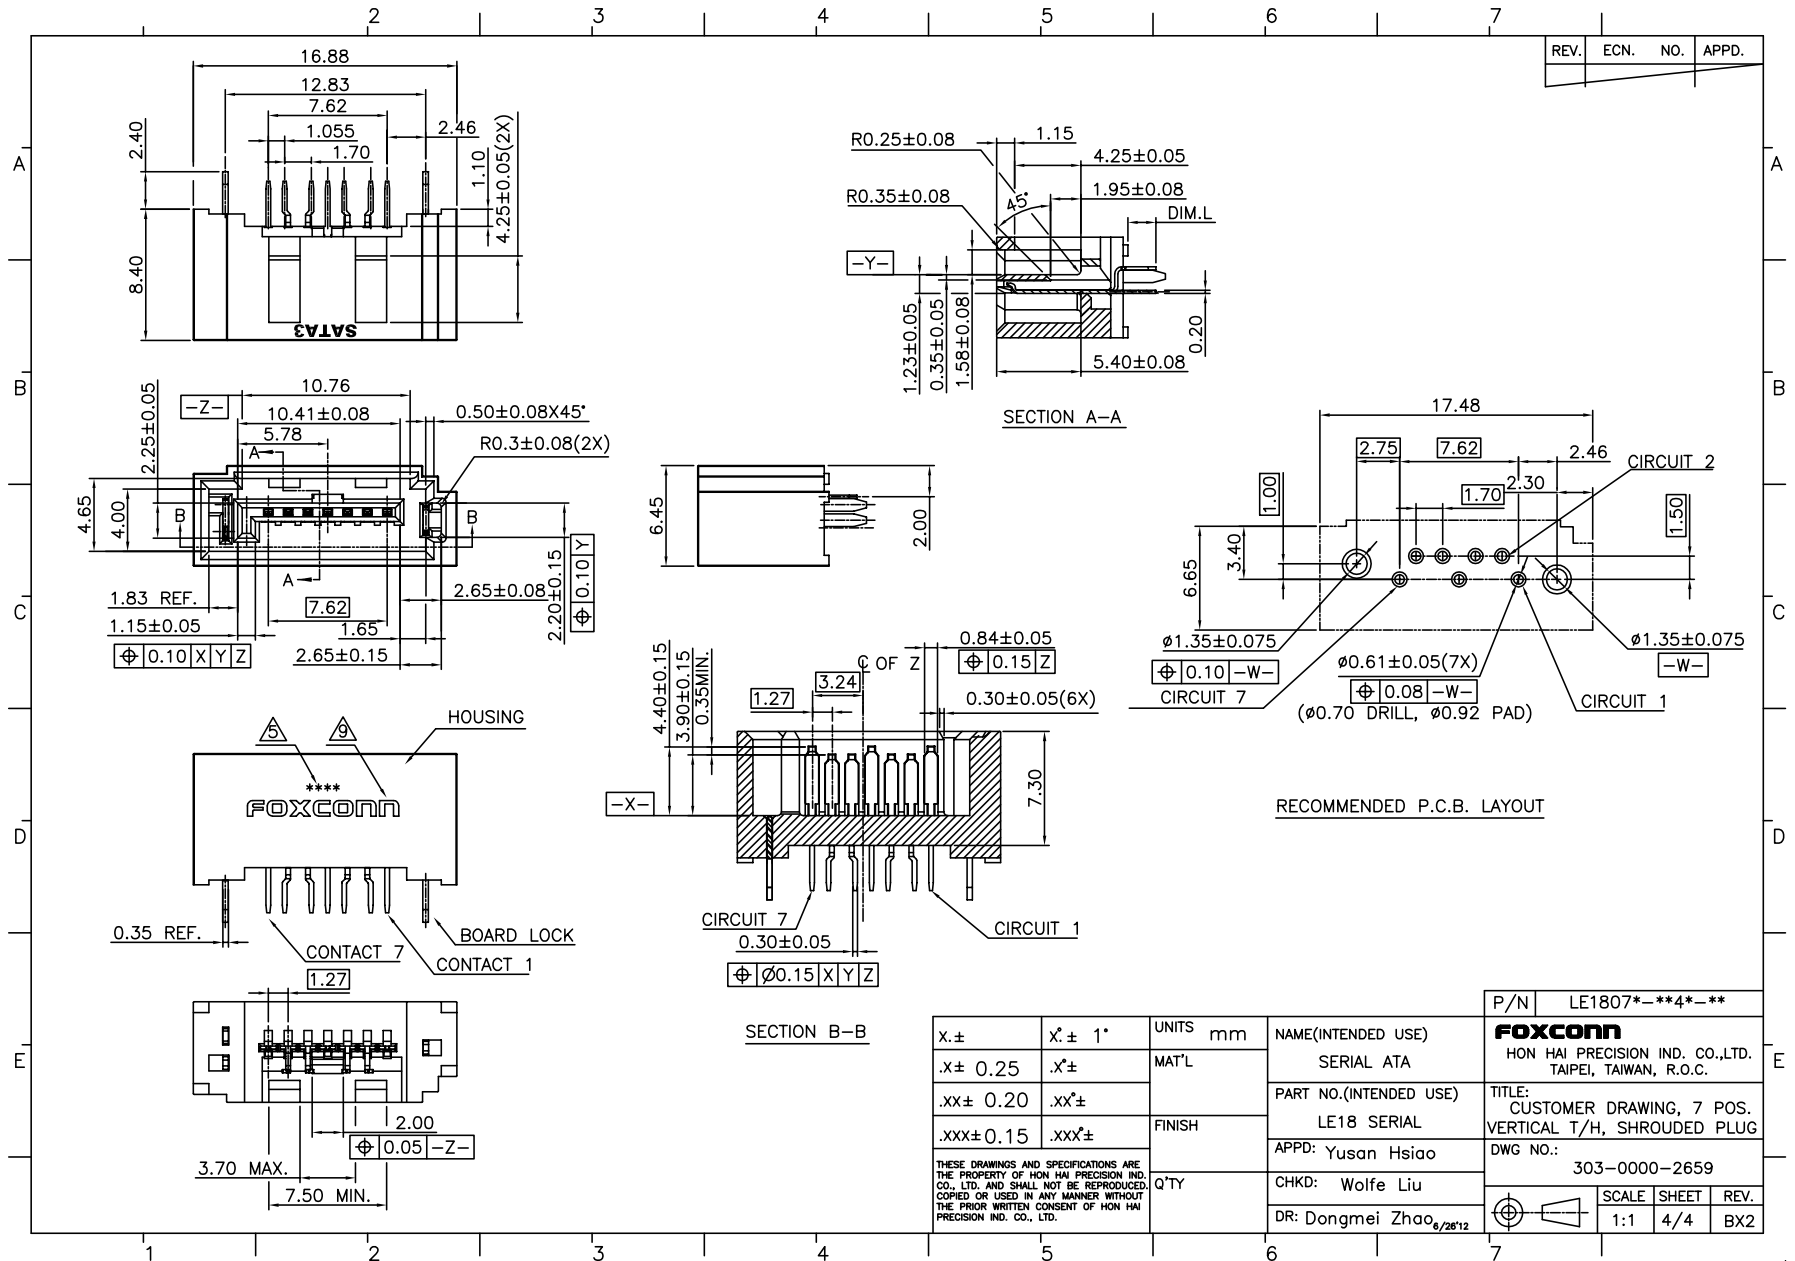
[picture p73: page 4]
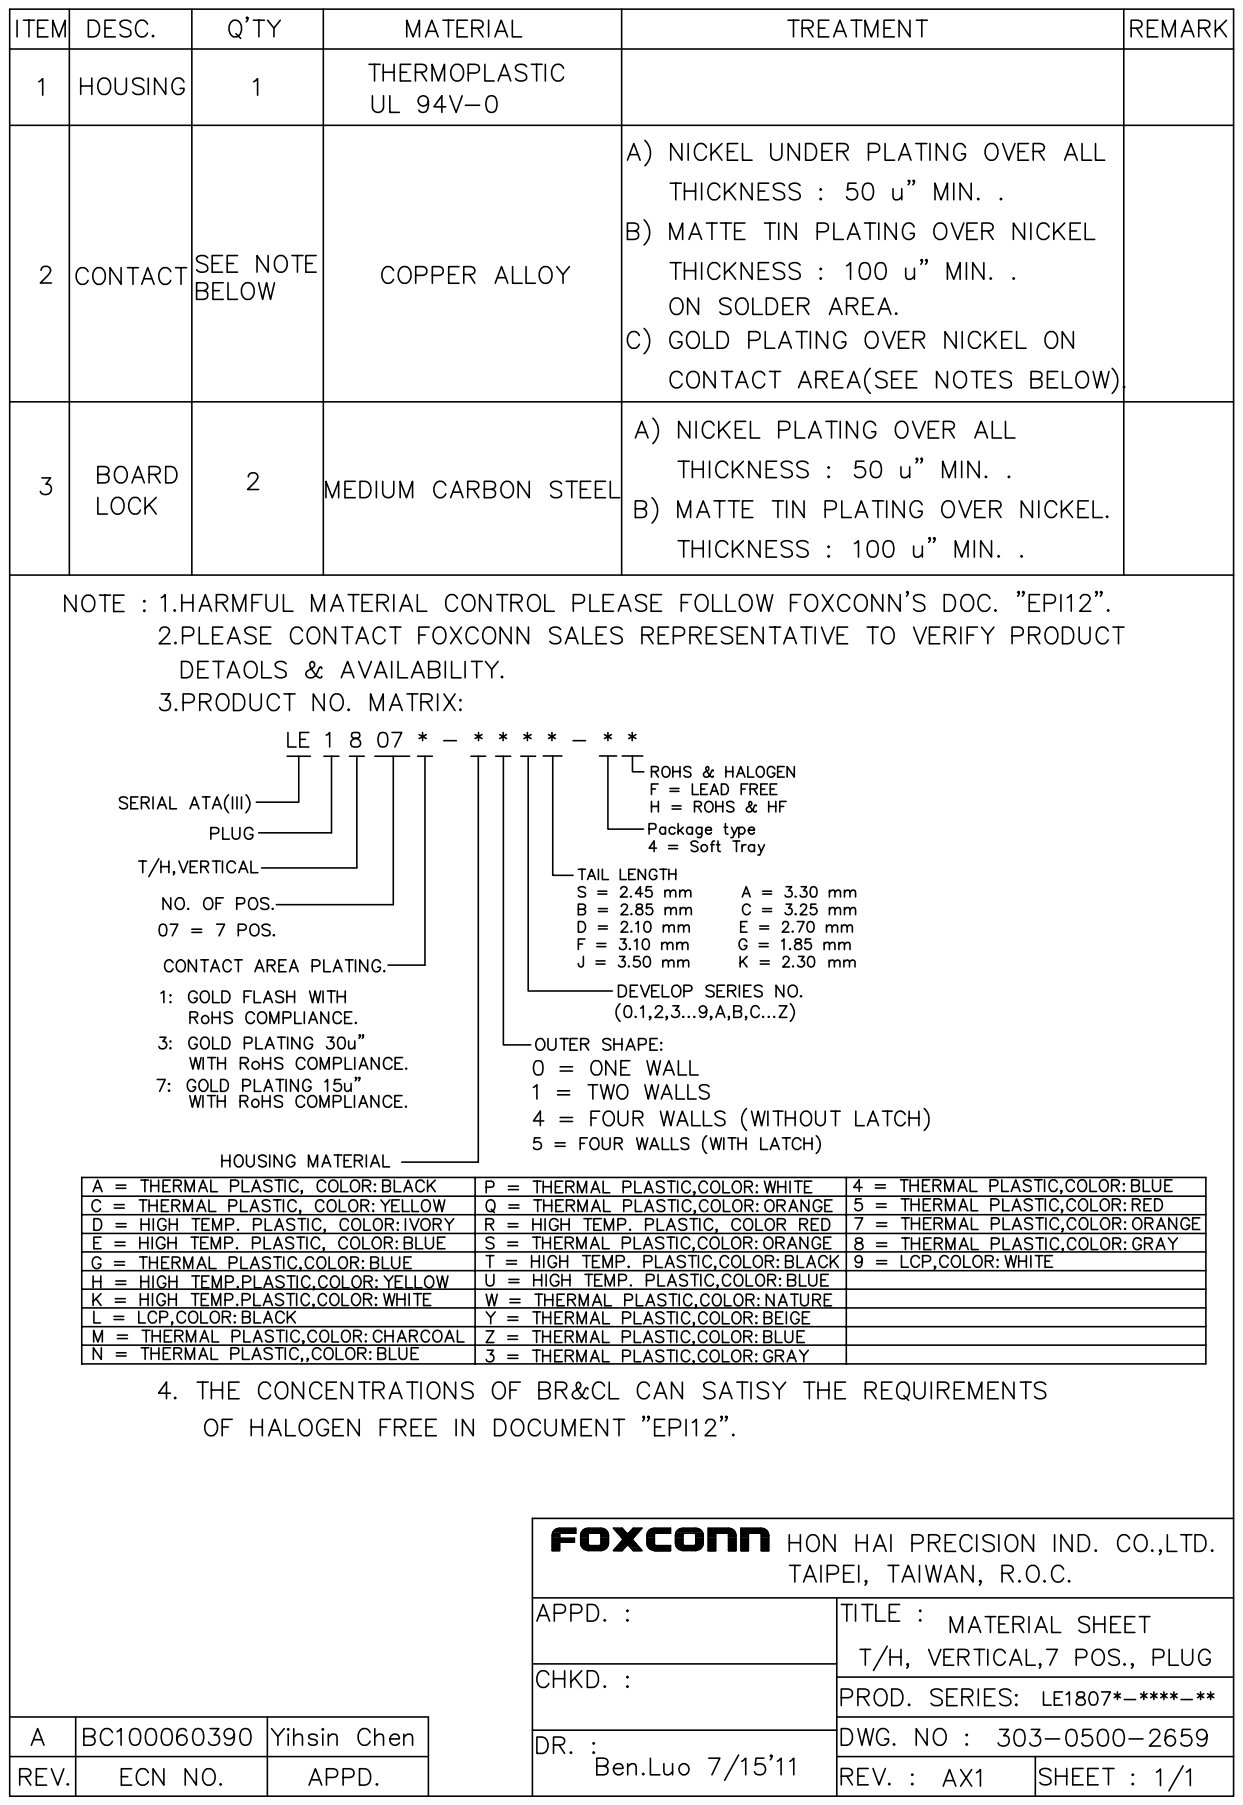
[picture p74: page 5]
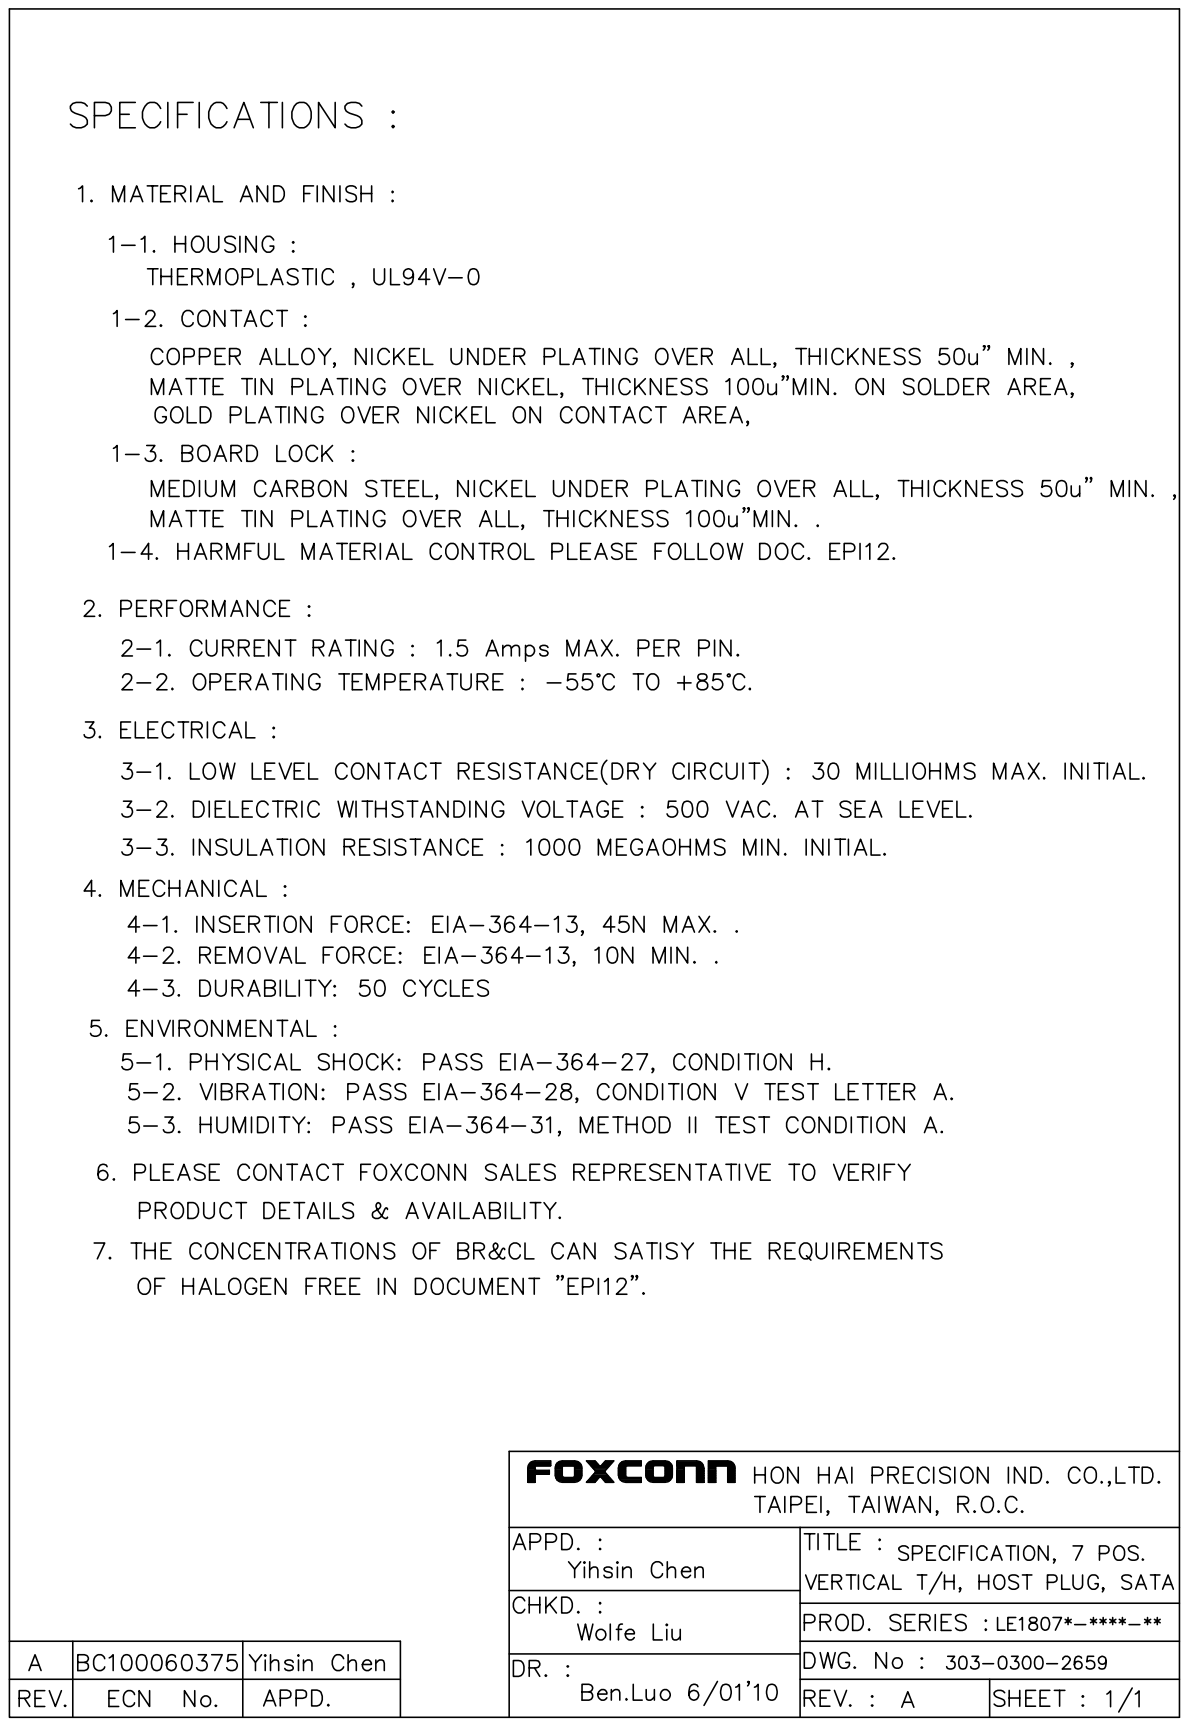
[picture p75: page 6]
