openedv/development_board_ATK-DLRK3588B/7_hardware/5_Board_mounted_connector_specifications/10_2mm_pitch_mounting_socket_22P(ALIENTEK_MIPI_Camera_Interface)/C2925567_2MM2X11P_2021-11-29.PDF

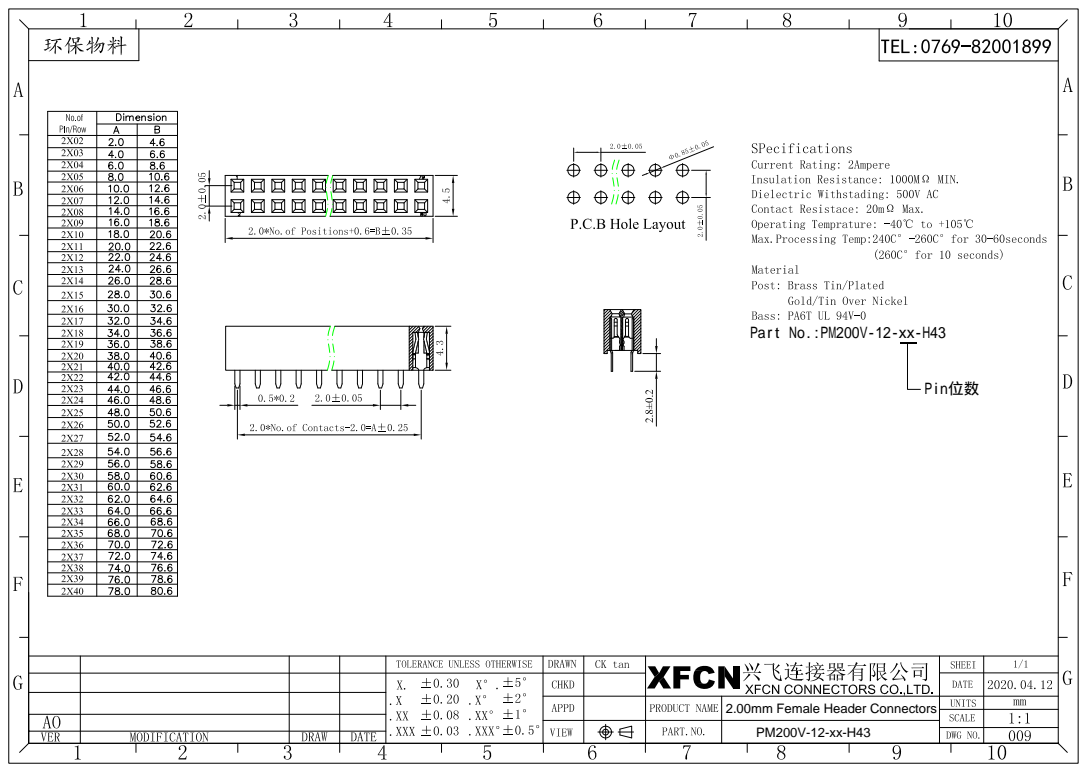
[picture p52: page 1]
Pin位数

2.00mm Female Header Connectors
