openedv/development_board_ATK-DLRK3588B/7_hardware/5_Board_mounted_connector_specifications/11_FPC_Connector_26P (ALIENTEK_MIPI_Screen_Interface)/C2911851_0.5MMP quantity_26 flip-down connection.PDF

B ±0.10

D

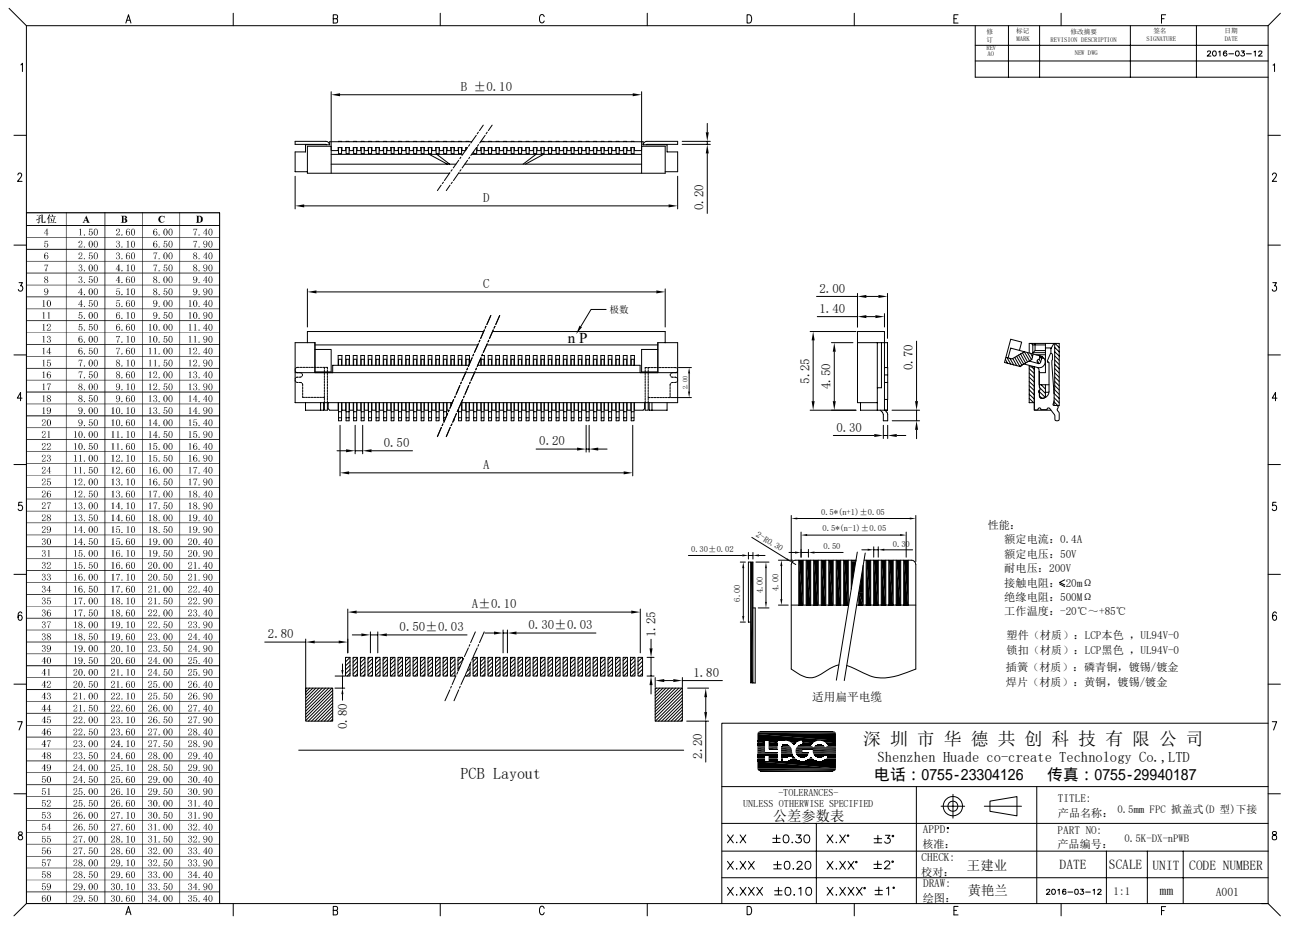
[picture p53: page 1]
性能： 额定电流：0.4A 额定电压：50V 耐电压：200V 接触电阻： 20mΩ 绝缘电阻：500MΩ 工作温度：-20℃～+85℃; 适用扁平电缆; PCB Layout; 0.5K-DX-nPWB; 公差参数表; APPD: 核准： CHECK: 校对： DRAW:; 修订REV; 标记MARK; 修改摘要 REVISION DESCRIPTION; 签名 SIGNATURE; 日期 DATE Shenzhen Huade co-create Technology Co.,LTD -TOLERANCES- UNLESS OTHERWISE SPECIFIED; mm TITLE: 产品名称： PART NO: 产品编号： AO; NEW DWG 王建业; DATE; SCALE; UNIT; CODE NUMBER 黄艳兰

塑件（材质）：LCP本色 ，UL94V-0
锁扣（材质）：LCP黑色 ，UL94V-0
插簧（材质）：磷青铜，镀锡/镀金

0.5mm FPC 掀盖式(D 型)下接
