openedv/development_board_ATK-DLRK3588B/7_hardware/5_Board_mounted_connector_specifications/14_Antenna_base/C914554_SMA Inner Hole Elbow.PDF

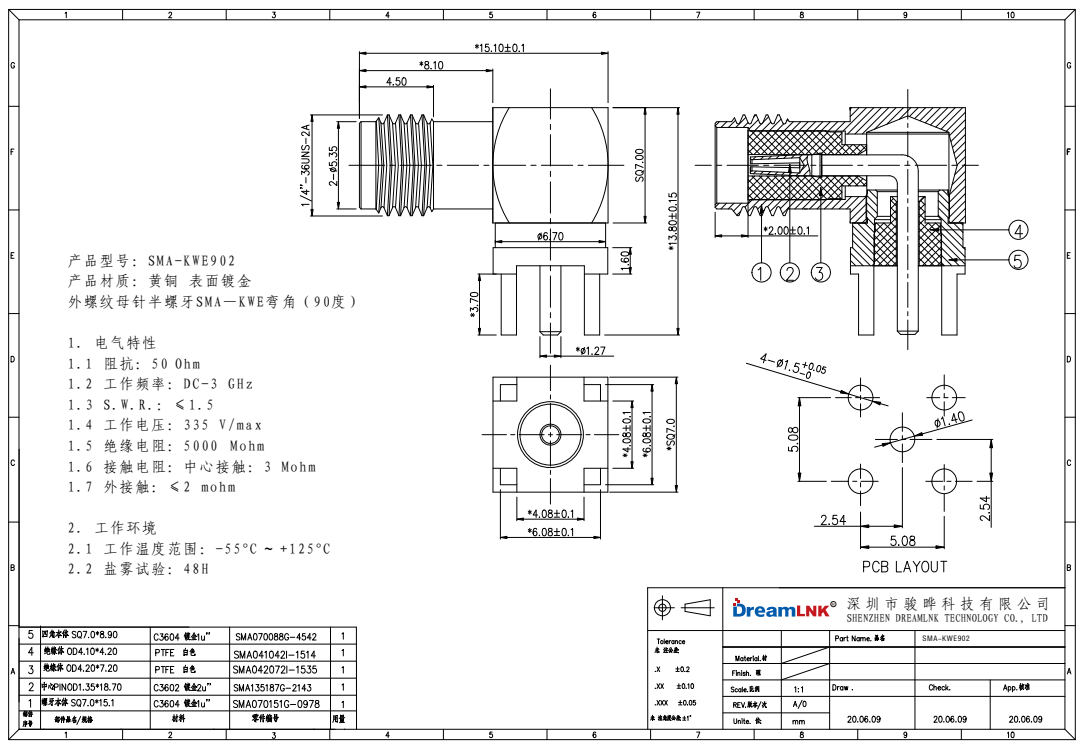
[picture p54: page 1]
SMA-KWE902; 2. 工作环境 2.1 工作温度范围：-55; 2.2 盐雾试验：48H

产品型号：SMA-KWE902
产品材质：黄铜 表面镀金
外螺纹母针半螺牙SMA—KWE弯角（90度）

1. 电气特性
1.1 阻抗：50 Ohm
1.2 工作频率：DC-3 GHz
1.4 工作电压：335 V/max
1.5 绝缘电阻：5000 Mohm
1.6 接触电阻：中心接触：3 Mohm
1.7 外接触：≤2 mohm

深圳市骏晔科技有限公司
SHENZHEN DREAMLNK TECHNOLOGY CO., LTD
