openedv/development_board_ATK-DLRK3588B/7_hardware/5_Board_mounted_connector_specifications/17_SATA_connector/4P Large Power Socket_M5082VK-04P - Specification Book_XFCN (Xinfeng) Wire-to-Board Connector Specification B.PDF

## Specifications :

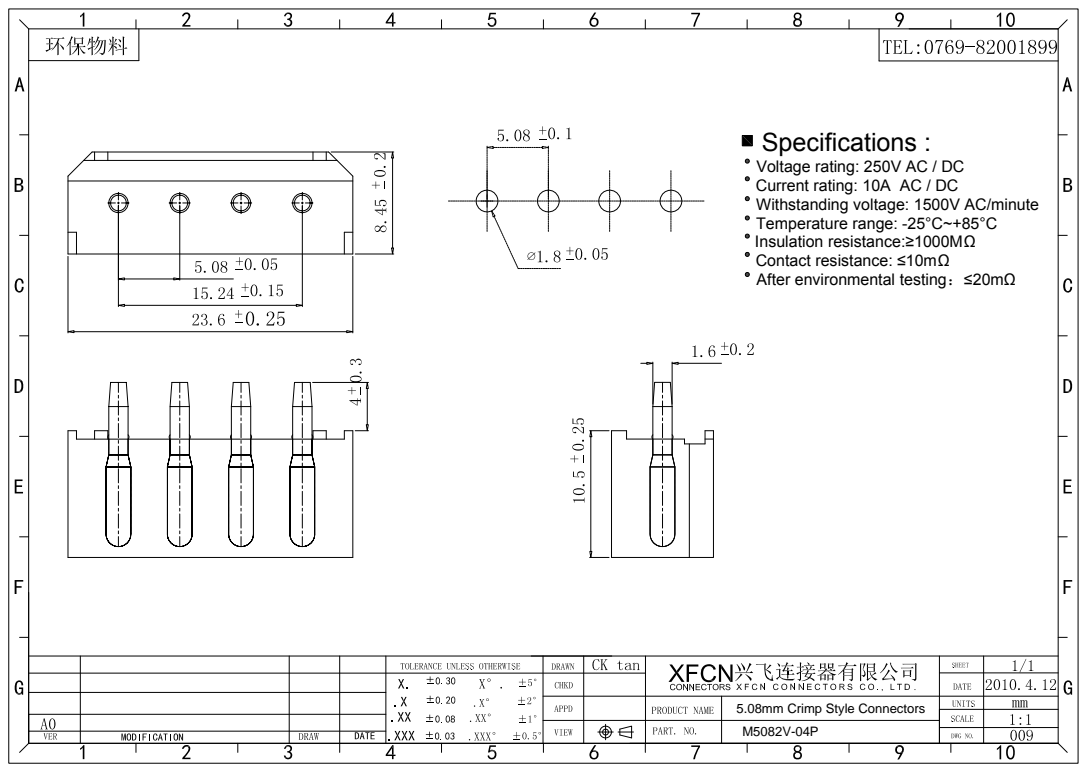
[picture p55: page 1]

Voltage rating: 250V AC / DC
Current rating: 10A AC / DC
Withstanding voltage: 1500V AC/minute
Temperature range: -25°C~+85°C
Insulation resistance:
Contact resistance:
After environmental testing：≤20m

5.08mm Crimp Style Connectors
