openedv/development_board_ATK-DLRK3588B/7_hardware/4_Mechanical_dimensions/ATK-DLRK3588B V1.0(Basrboard mechanical dimension drawing).pdf

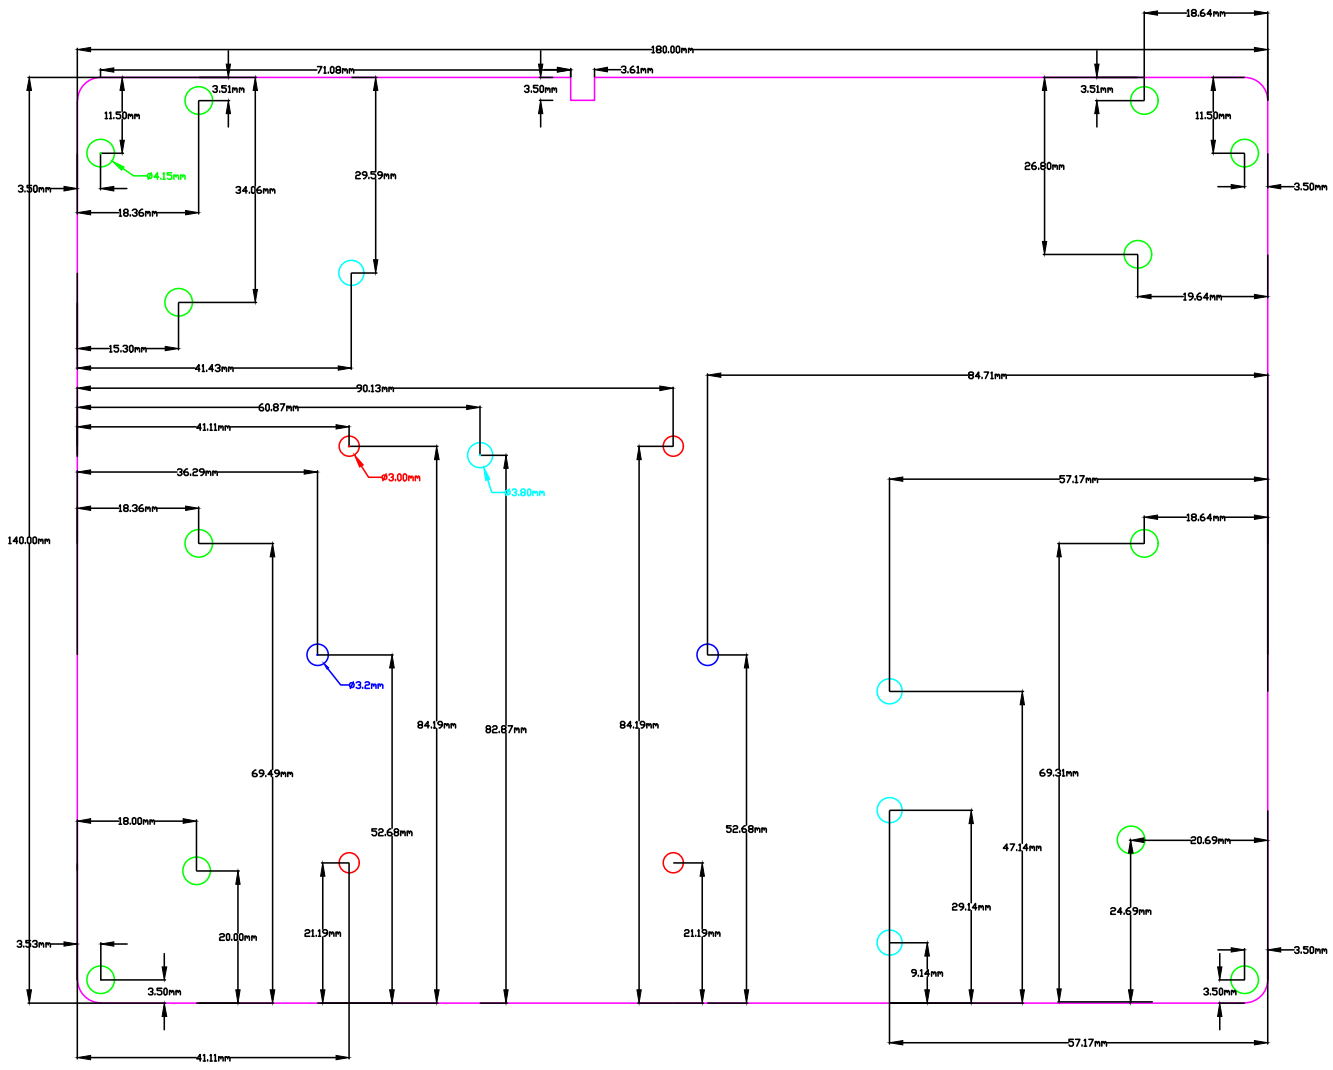
[picture p56: page 1]
