openedv/development_board_ATK-DLRK3588B/2_sch/02_Other_Modules_Schematic_Diagram/ATK-MCIMX335 V1.3 schematic diagram.pdf

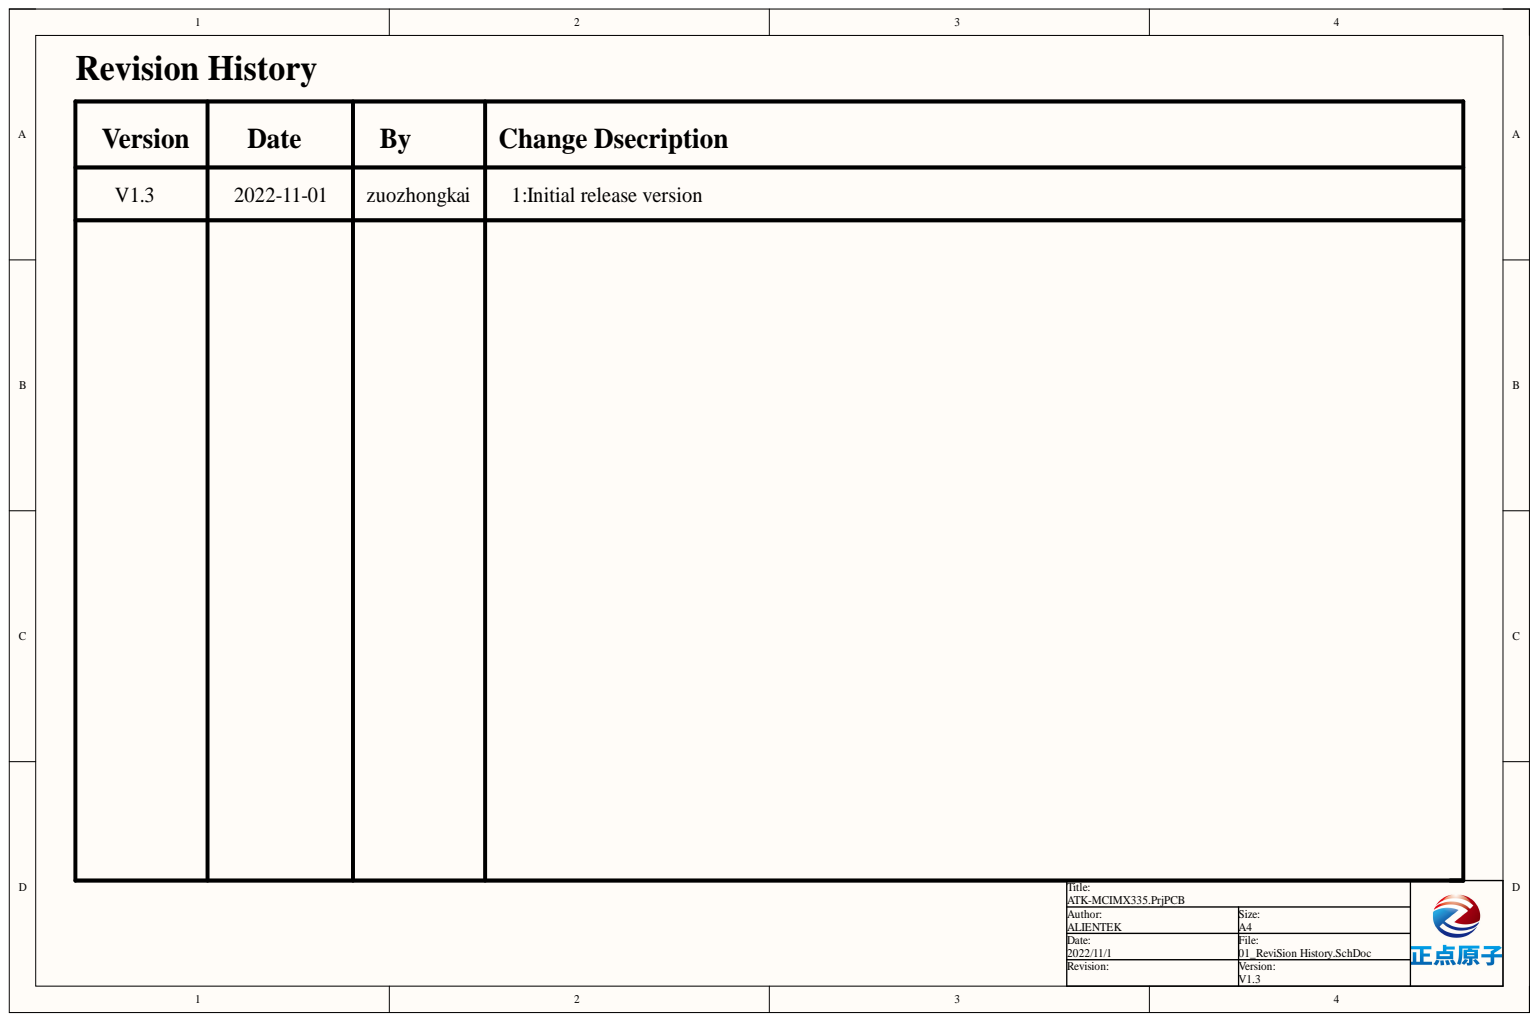
[picture p57: page 1]

Version | Date | By | Change Dsecription

V1.3 | 2022-11-01 | zuozhongkai | 1:Initial release version

Title: ATK-MCIMX335.PrjPCB

Author: ALIENTEK | Size: A4

Date: 2022/11/1 | File: 01_ReviSion History.SchDoc

Revision: | Version: V1.3

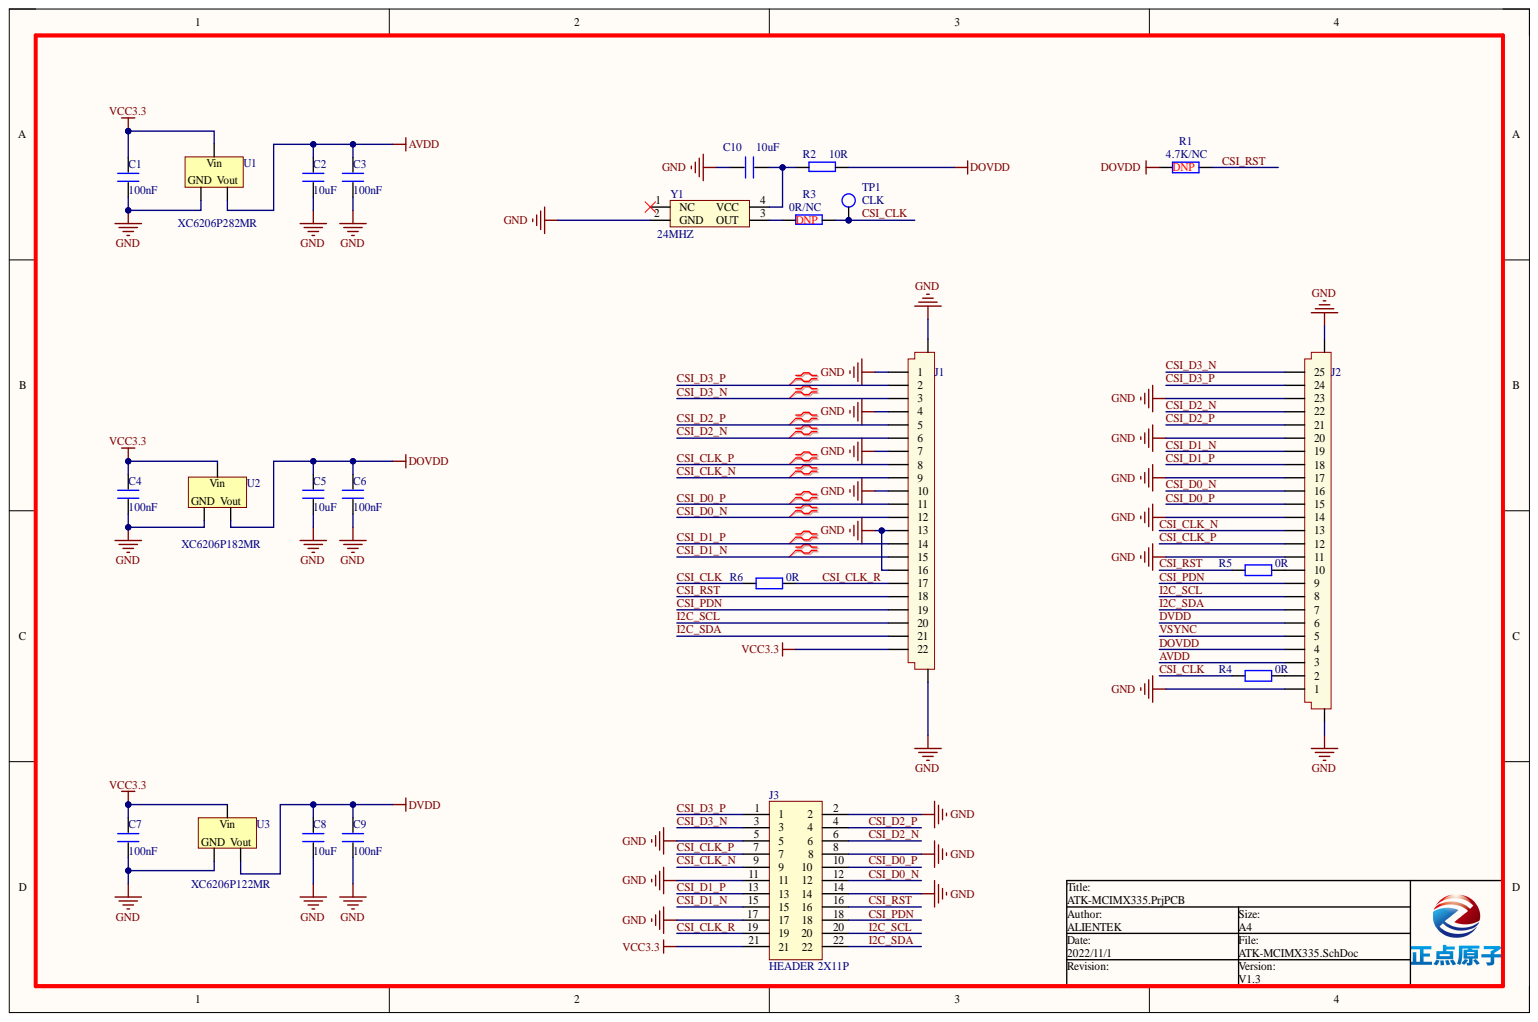
[picture p58: page 2]

A u t h or: A L IE N T E K | Size: A 4

Date: 2 0 2 2 / 1 1 / 1 | Fi le: AT K-MCIMX 3 3 5.Sch D o c

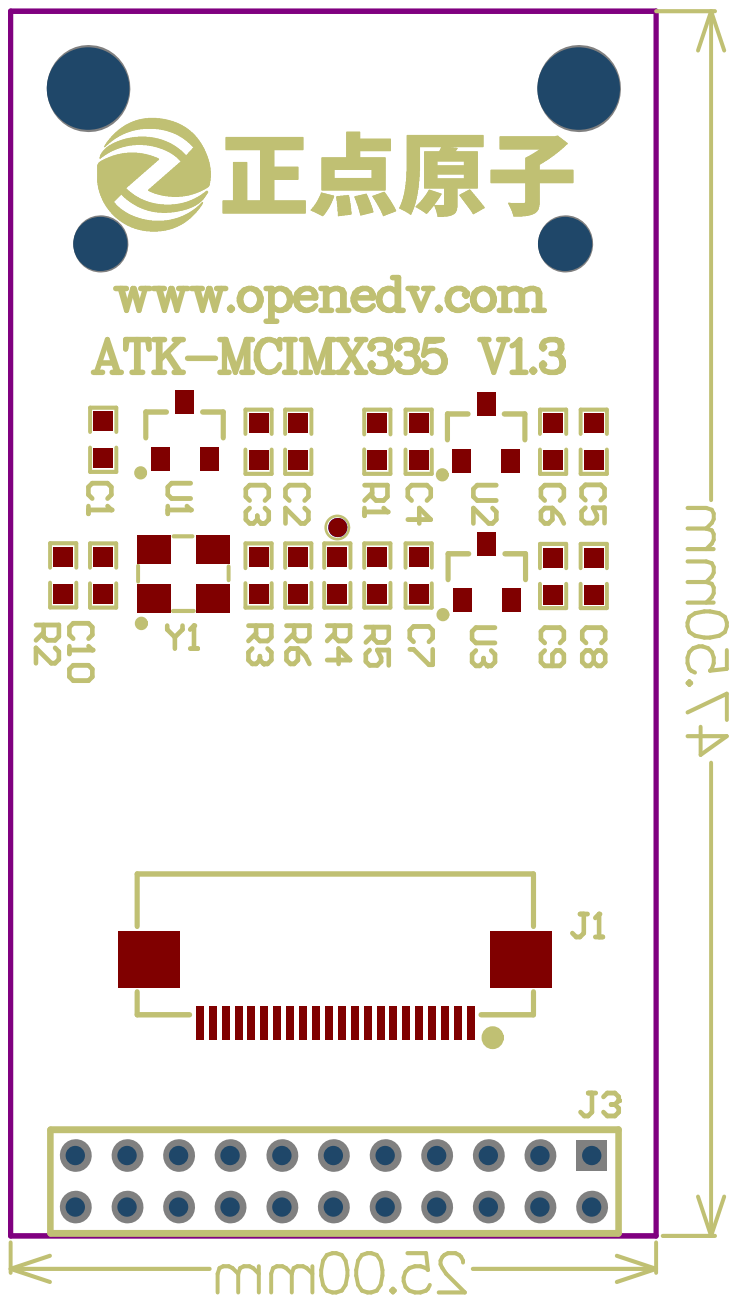
[picture p59: page 3]
