openedv/development_board_ATK-DLRK3588B/2_sch/02_Other_Modules_Schematic_Diagram/ATK-MCIMX415 V1.4 schematic diagram.pdf

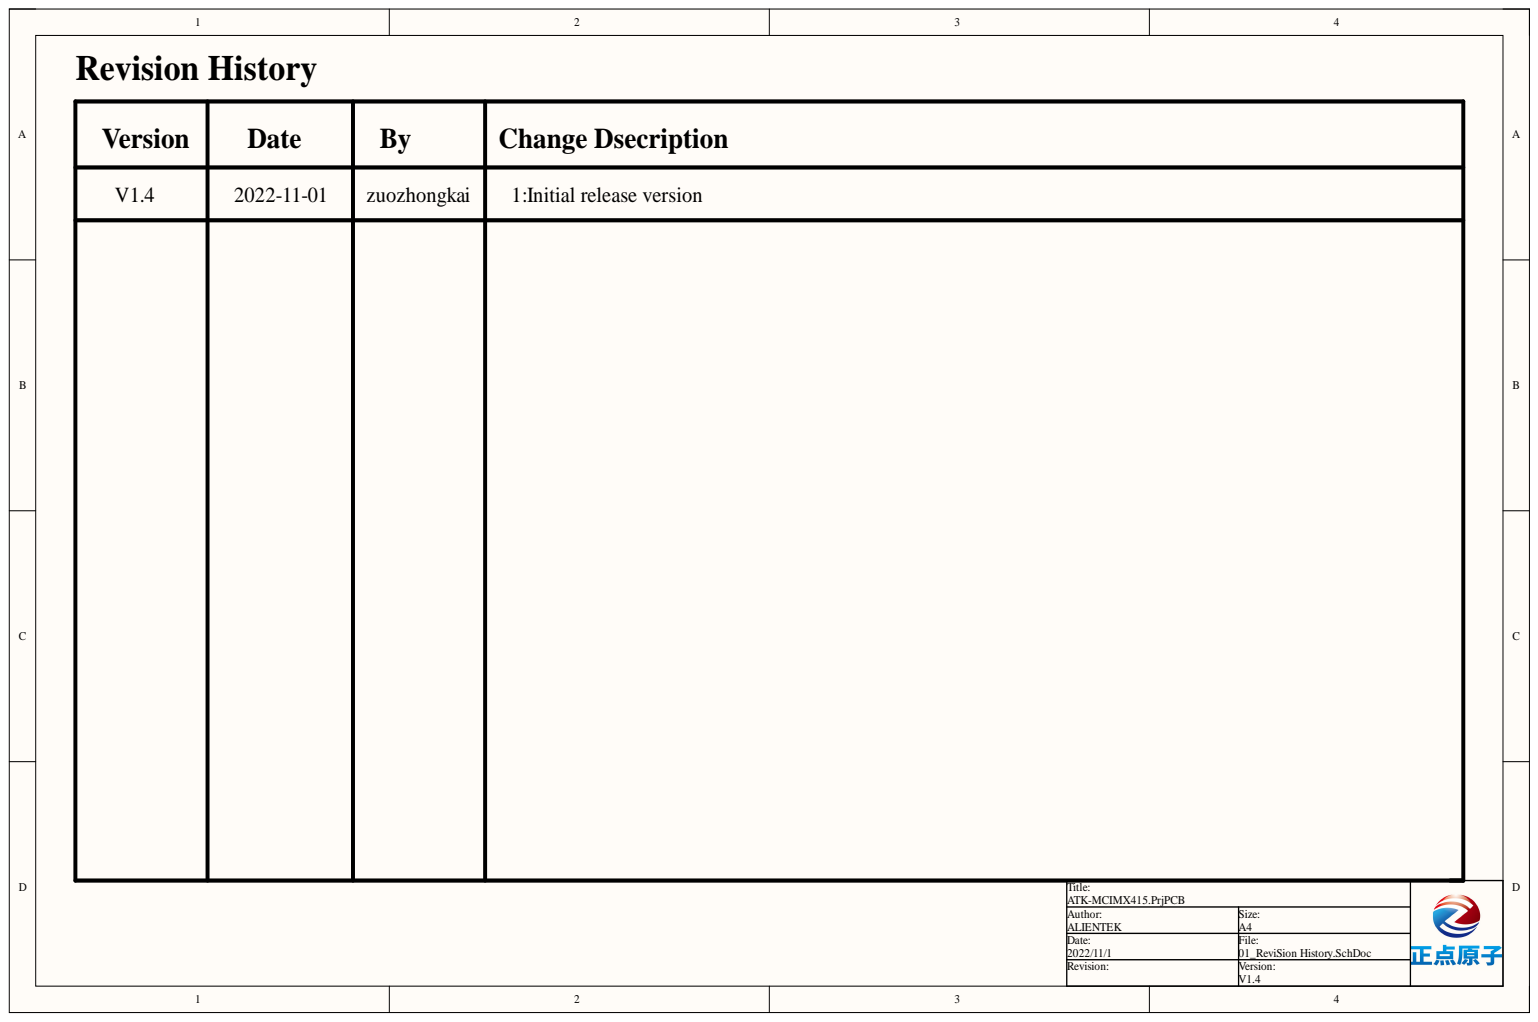
[picture p60: page 1]

Version | Date | By | Change Dsecription

V1.4 | 2022-11-01 | zuozhongkai | 1:Initial release version

Title: ATK-MCIMX415.PrjPCB

Author: ALIENTEK | Size: A4

Date: 2022/11/1 | File: 01_ReviSion History.SchDoc

Revision: | Version: V1.4
